martinkadauke/kabelsalat/bilder/etagen_iso.png

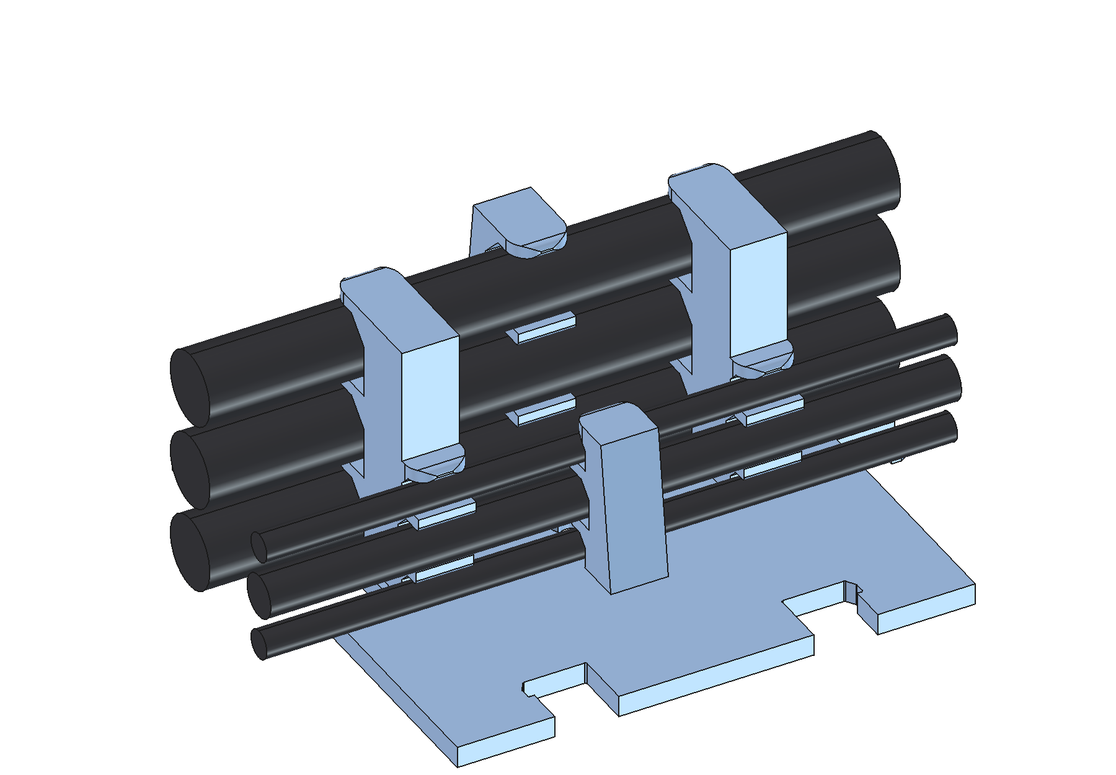
bilder/etagen_iso.png
