martinkadauke/kabelsalat/bilder/etagen_leer_iso.png

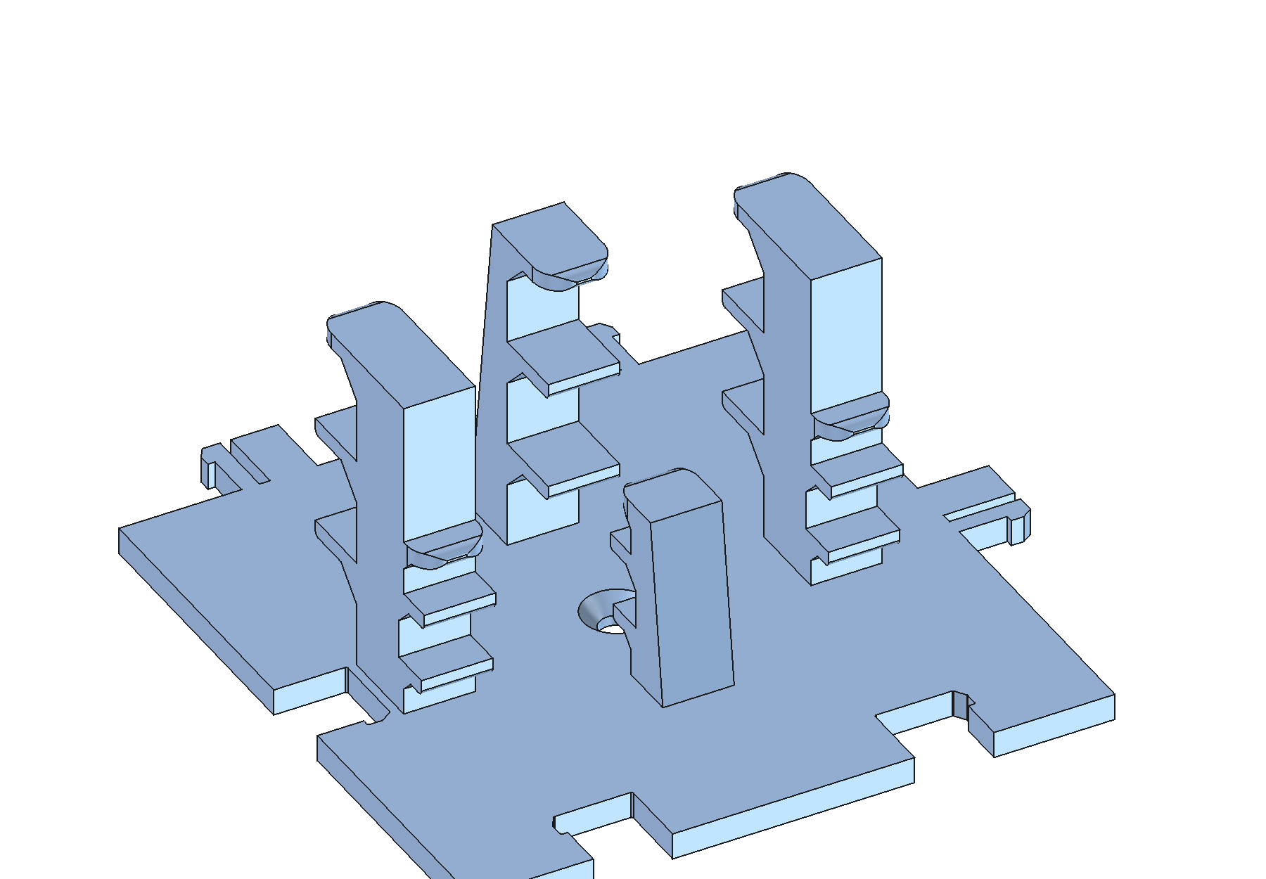
bilder/etagen_leer_iso.png
