martinkadauke/kabelsalat/bilder/etagen_mitte_schraeg.png

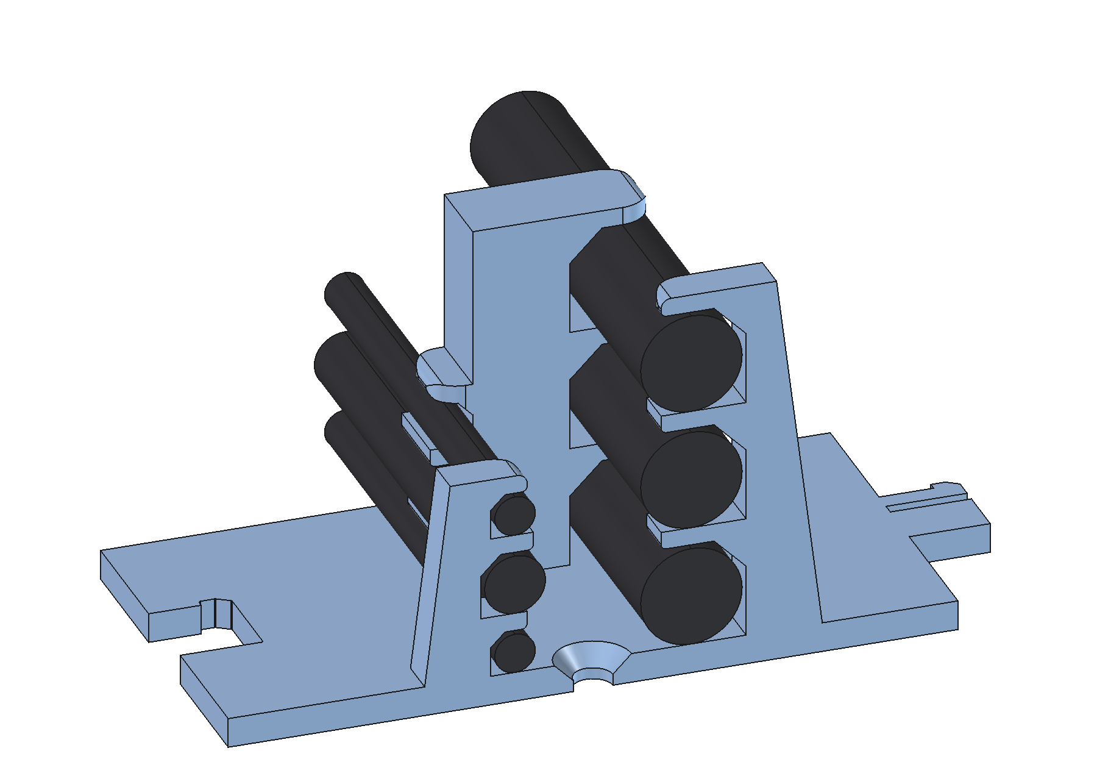
bilder/etagen_mitte_schraeg.png
