martinkadauke/kabelsalat/bilder/etagen_oben.png

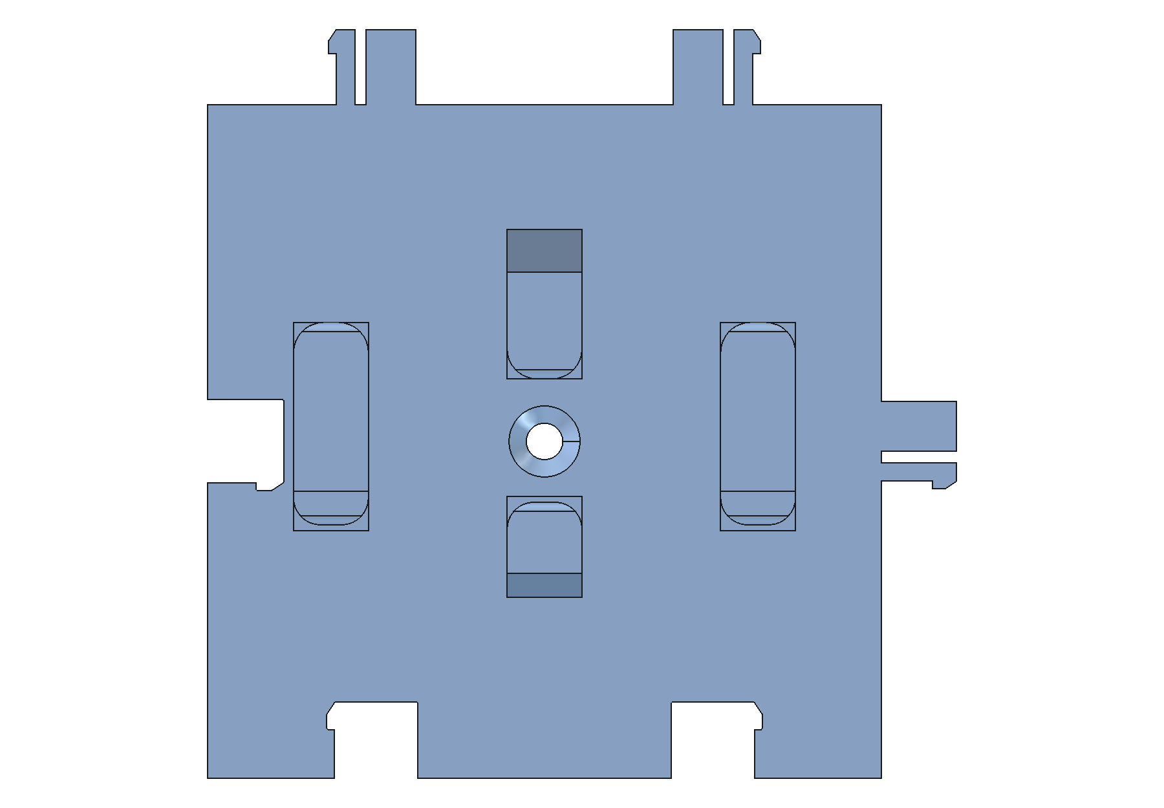
bilder/etagen_oben.png
