martinkadauke/kabelsalat/bilder/etagen_reihe.png

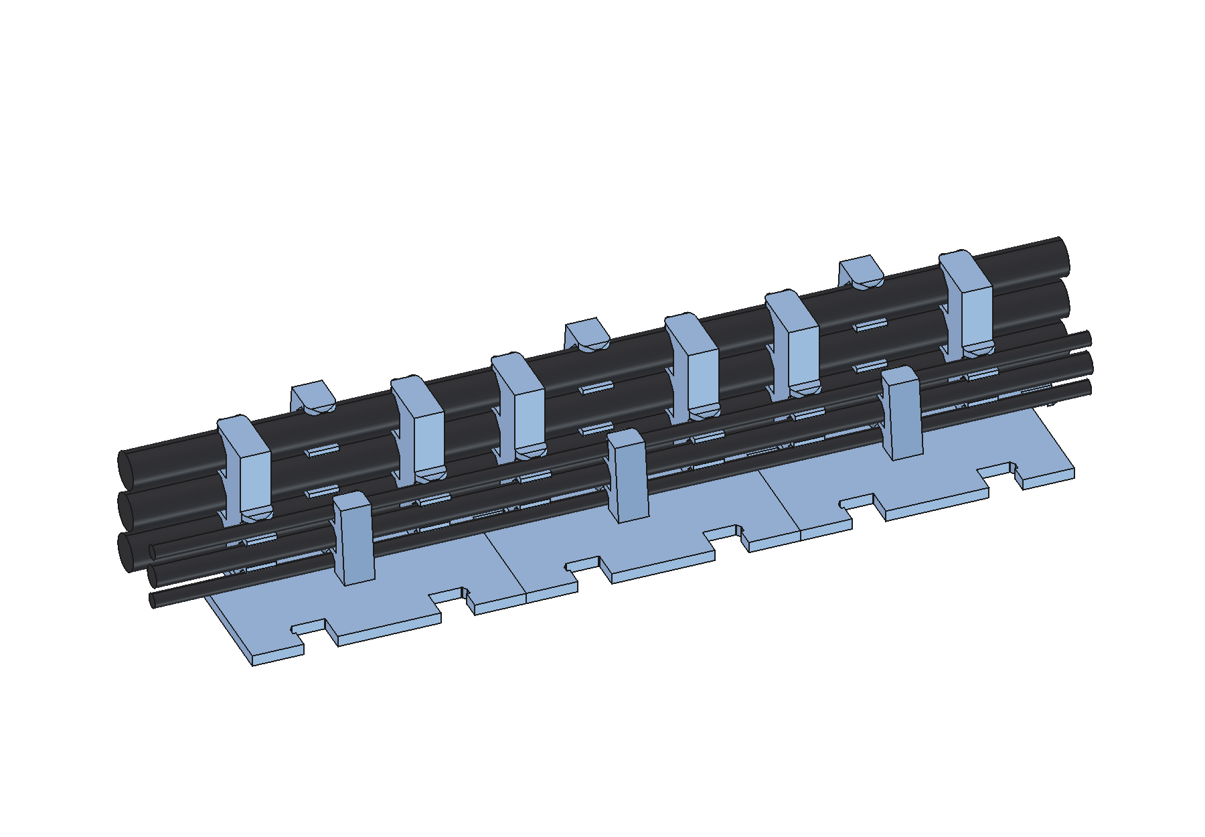
bilder/etagen_reihe.png
