martinkadauke/kabelsalat/bilder/etagen_schnitt.png

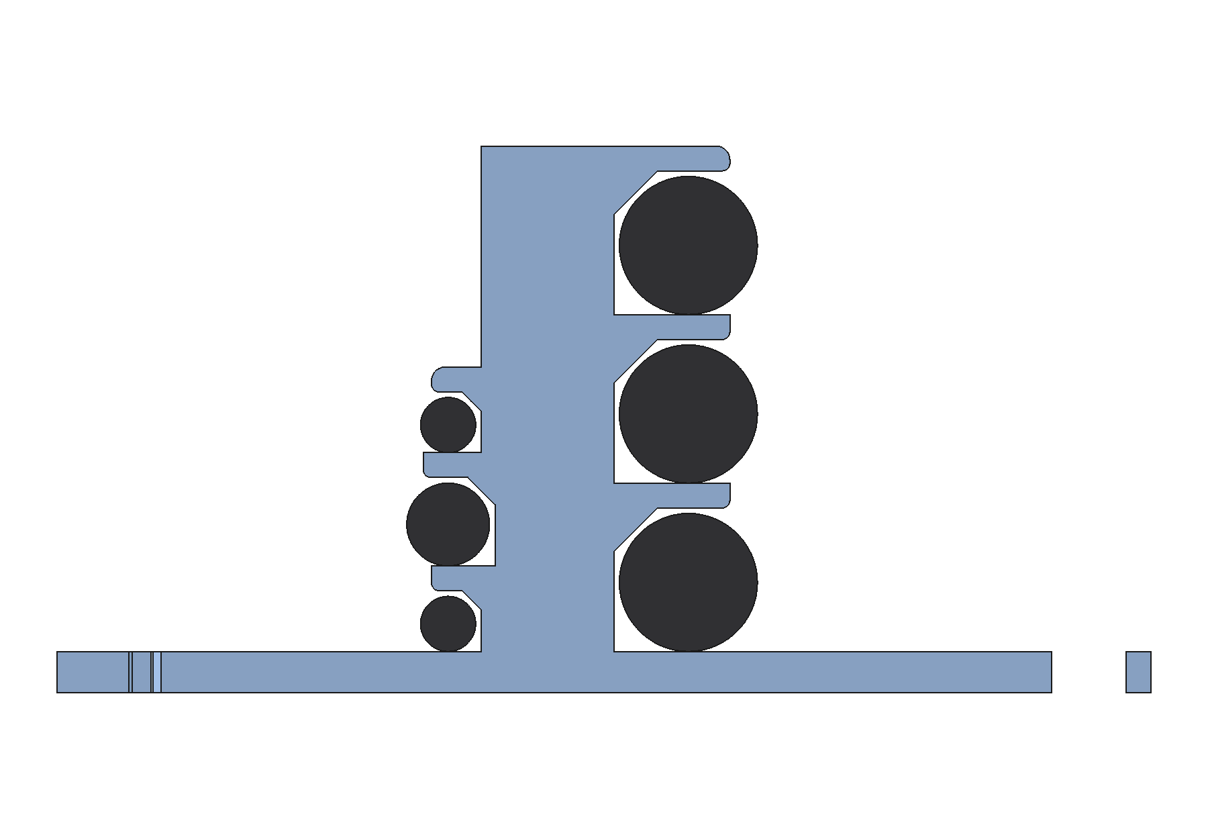
bilder/etagen_schnitt.png
