martinkadauke/kabelsalat/bilder/etagen_schnitt_schraeg.png

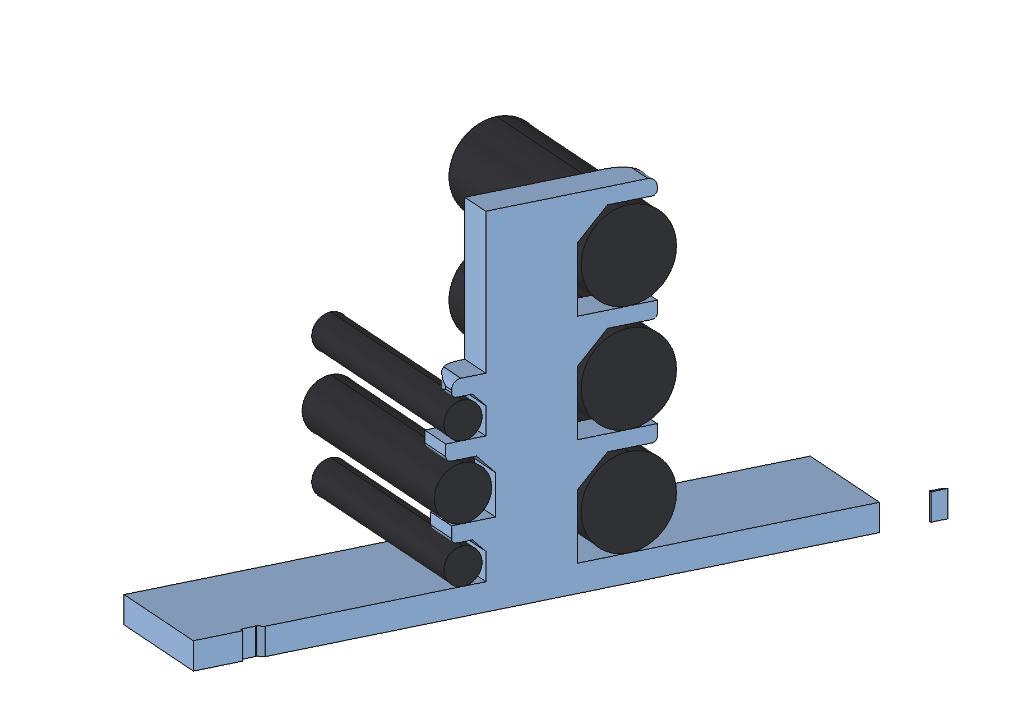
bilder/etagen_schnitt_schraeg.png
