martinkadauke/kabelsalat/bilder/etagen_vergleich.png

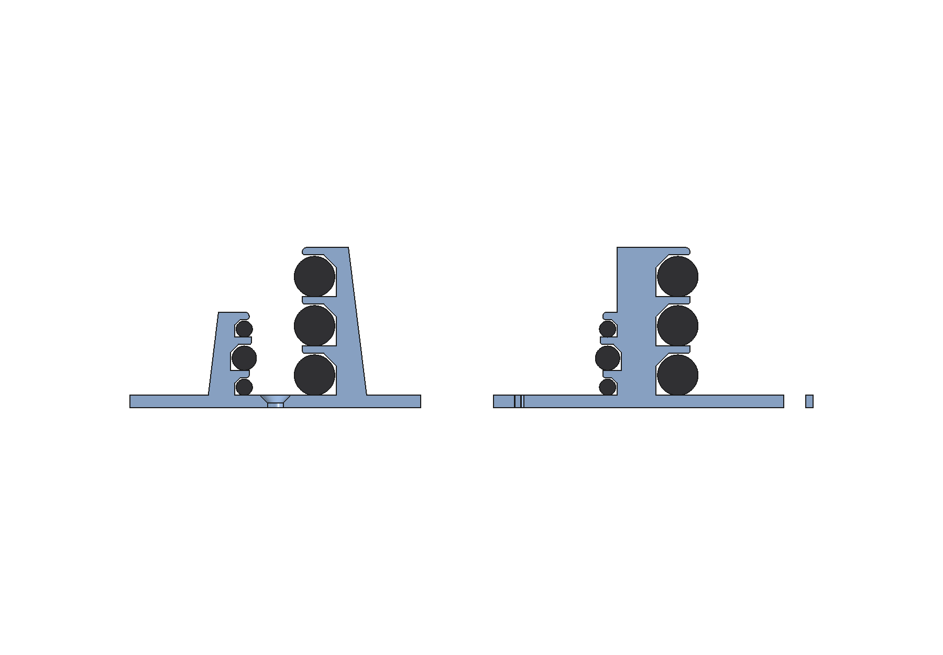
bilder/etagen_vergleich.png
