martinkadauke/kabelsalat/bilder/gemischt_iso.png

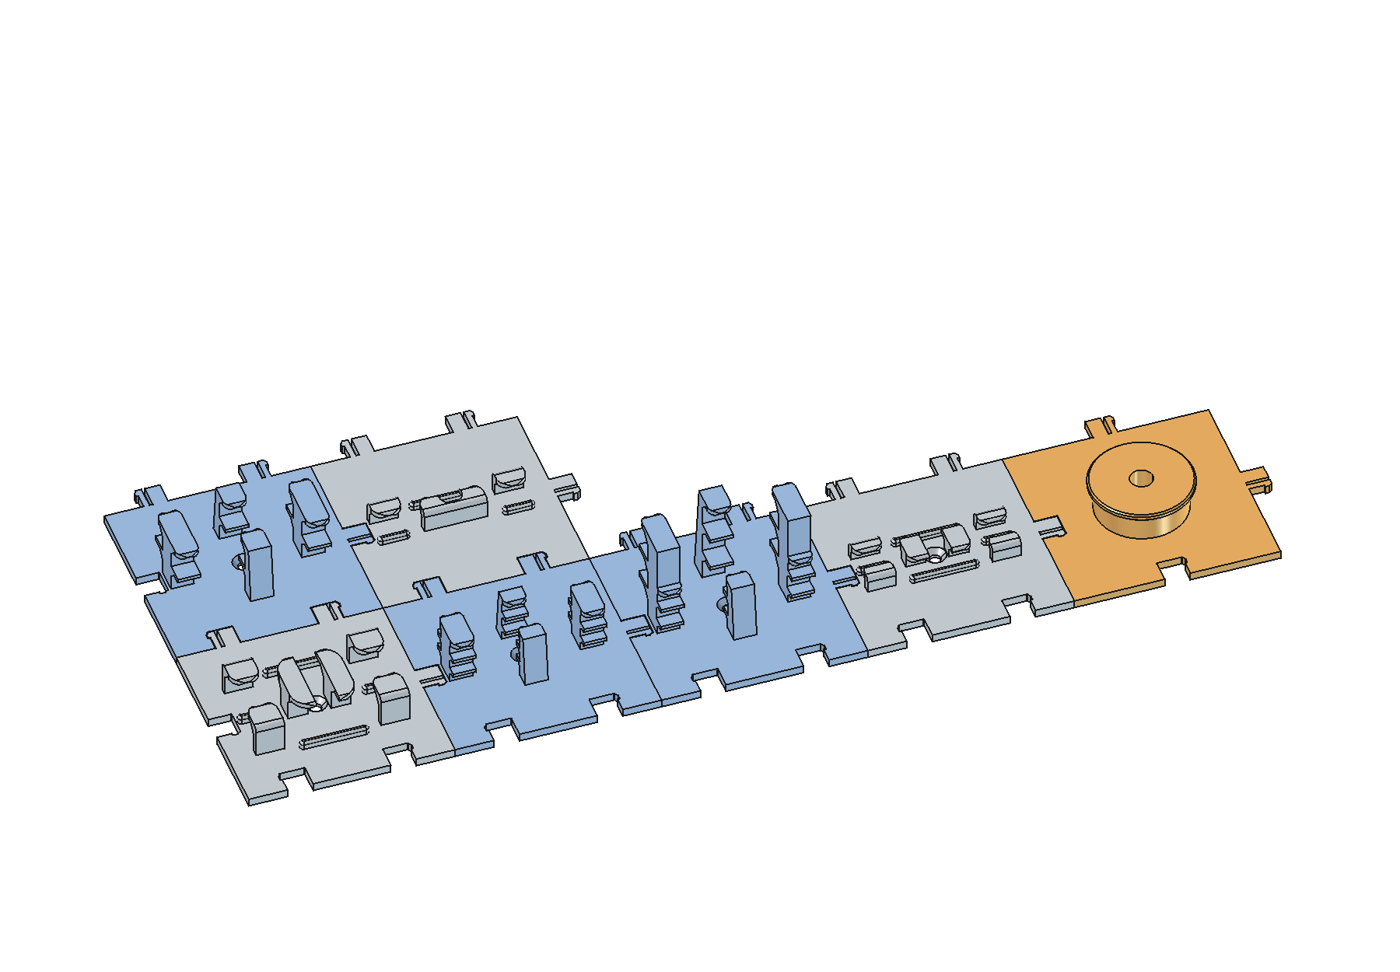
bilder/gemischt_iso.png
