martinkadauke/kabelsalat/bilder/gemischt_oben.png

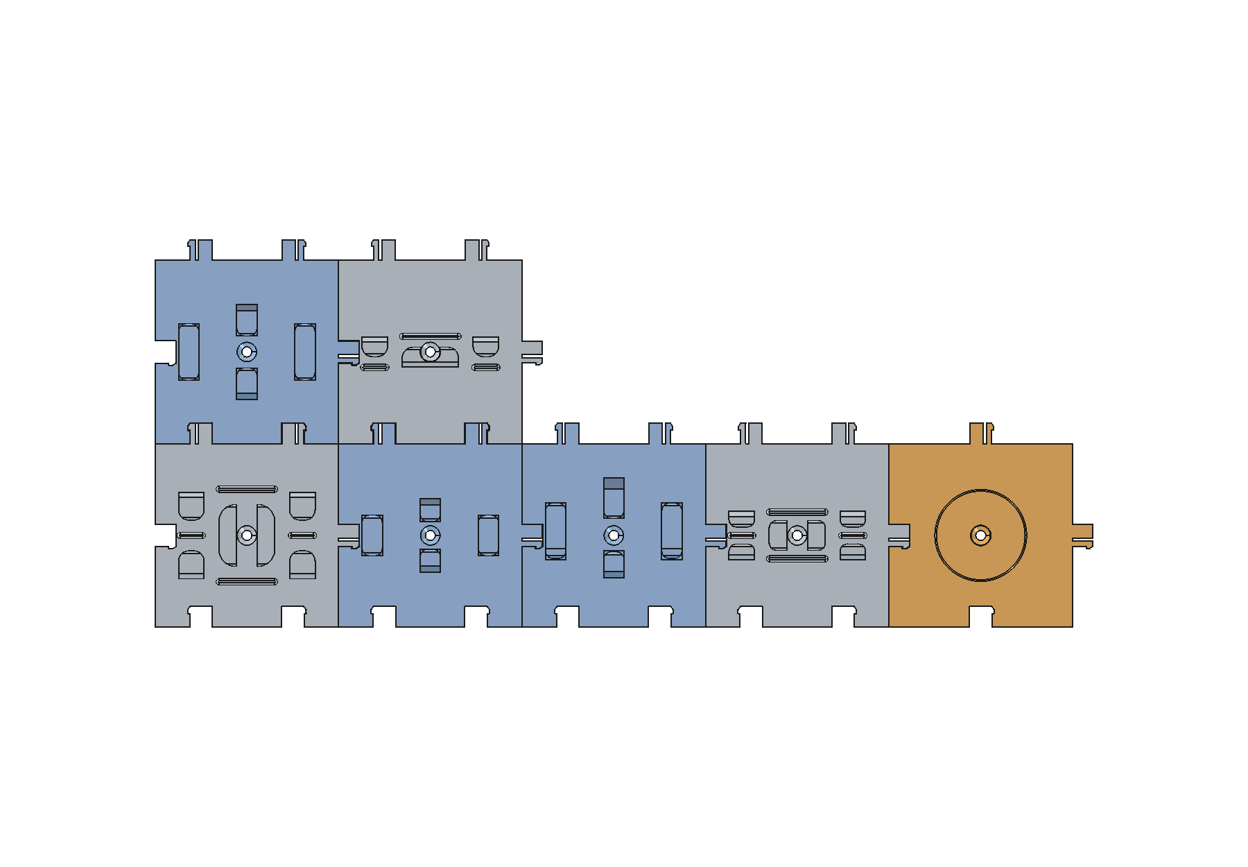
bilder/gemischt_oben.png
