martinkadauke/kabelsalat/bilder/grundformen.png

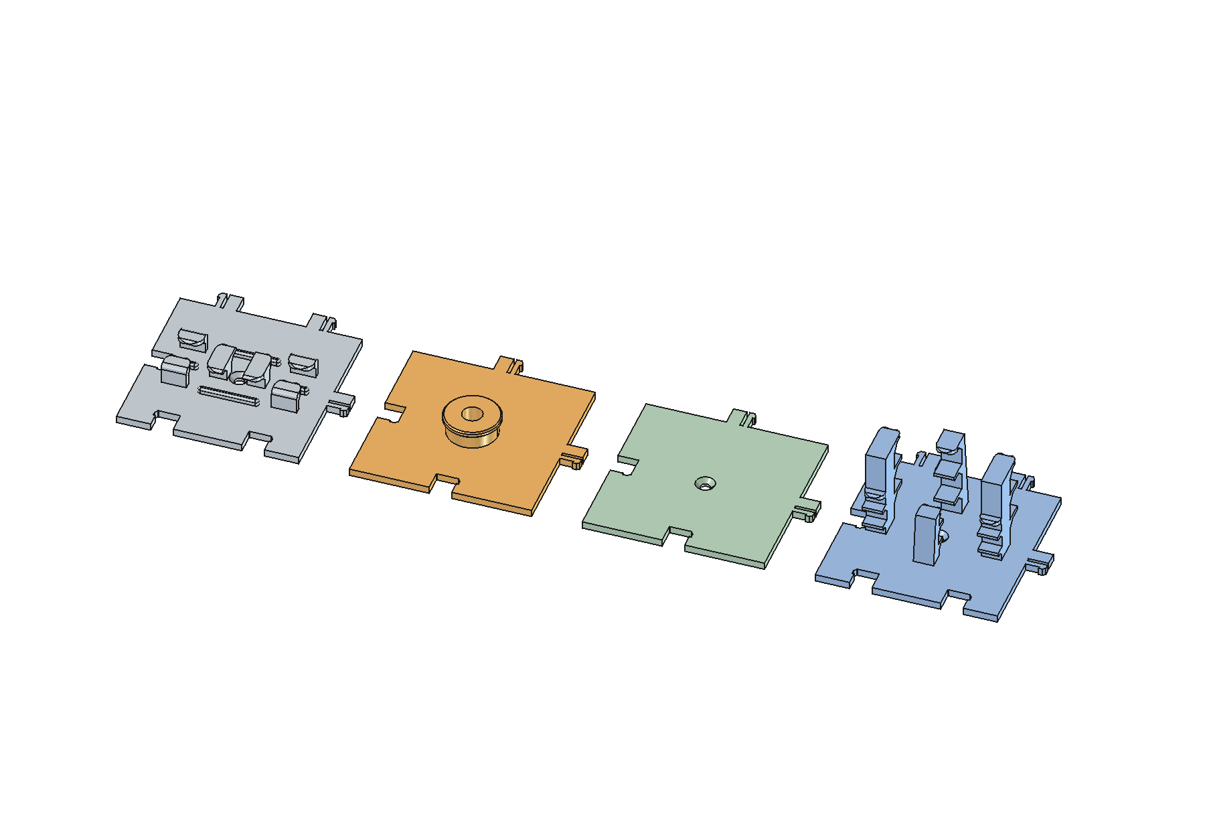
bilder/grundformen.png
