martinkadauke/kabelsalat/bilder/kachel_1spur_leer.png

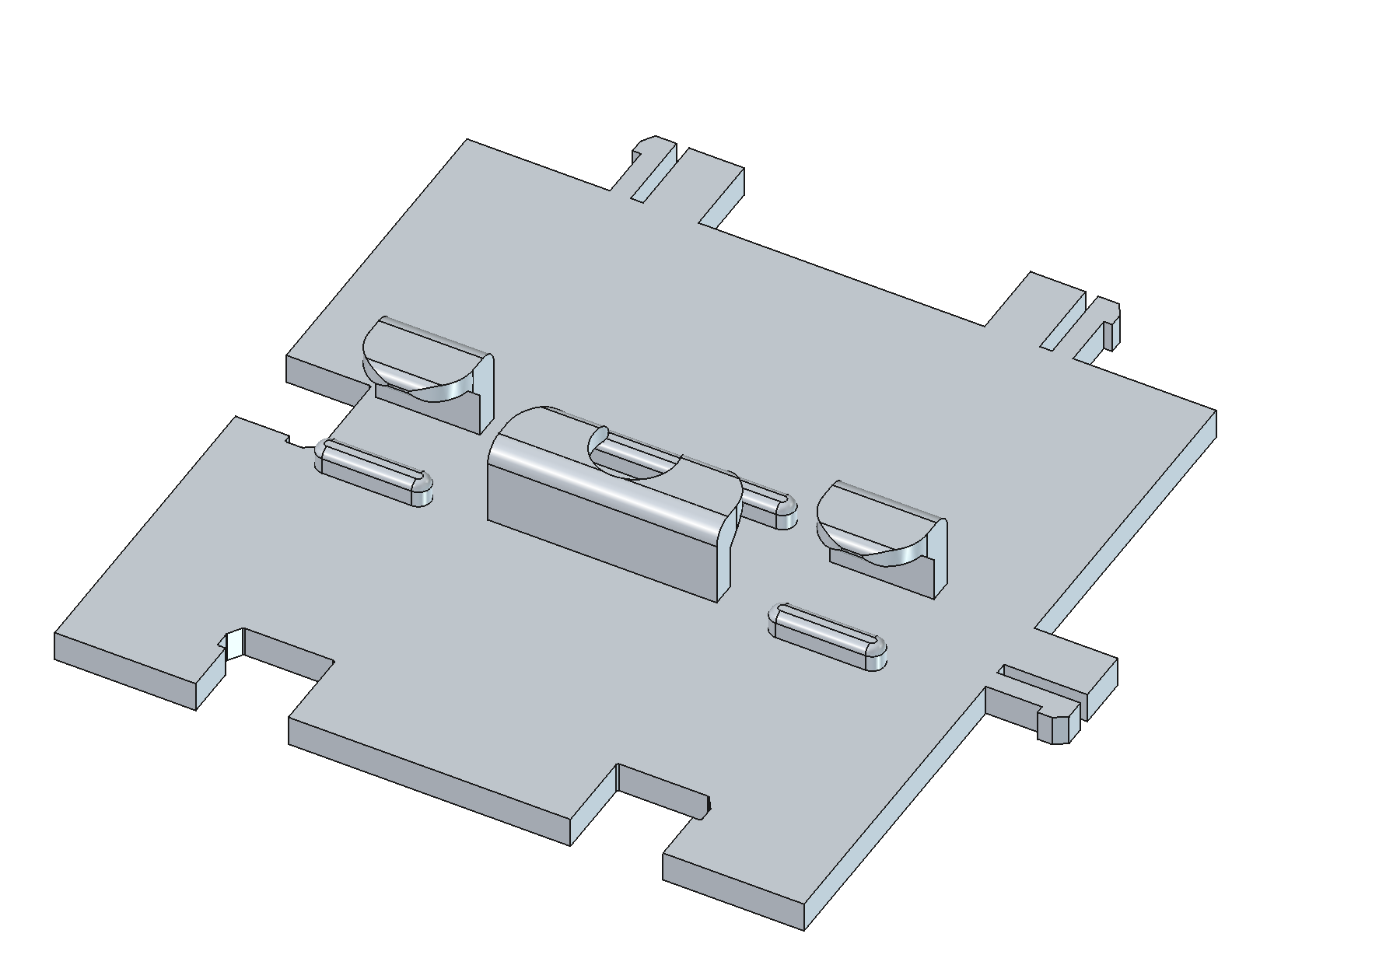
bilder/kachel_1spur_leer.png
