martinkadauke/kabelsalat/bilder/kachel_1spur_wie_foto.png

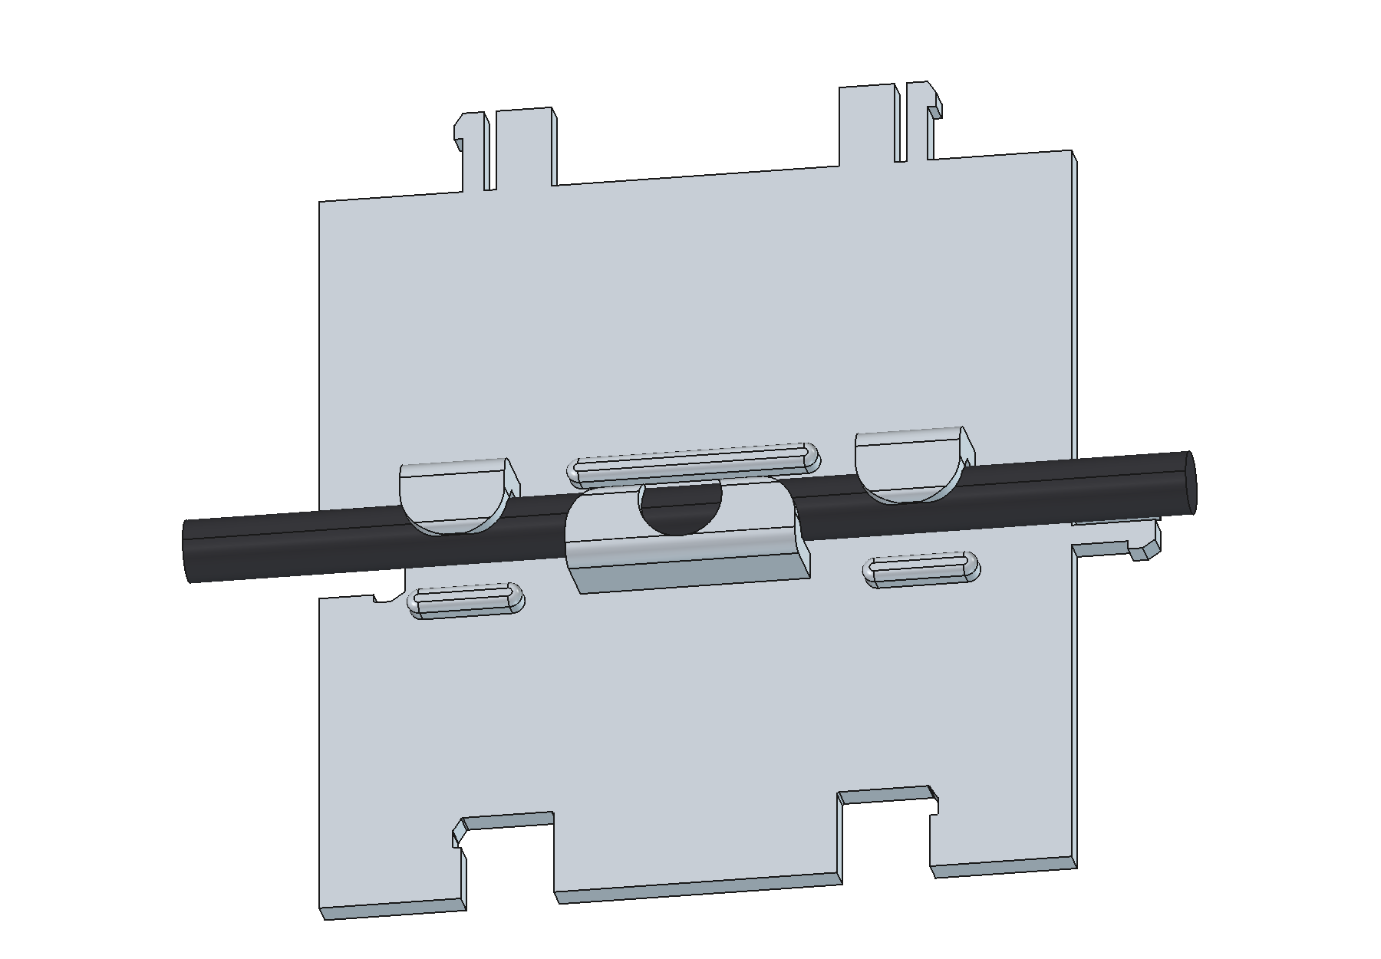
bilder/kachel_1spur_wie_foto.png
