martinkadauke/kabelsalat/bilder/kachel_2spur_wie_foto.png

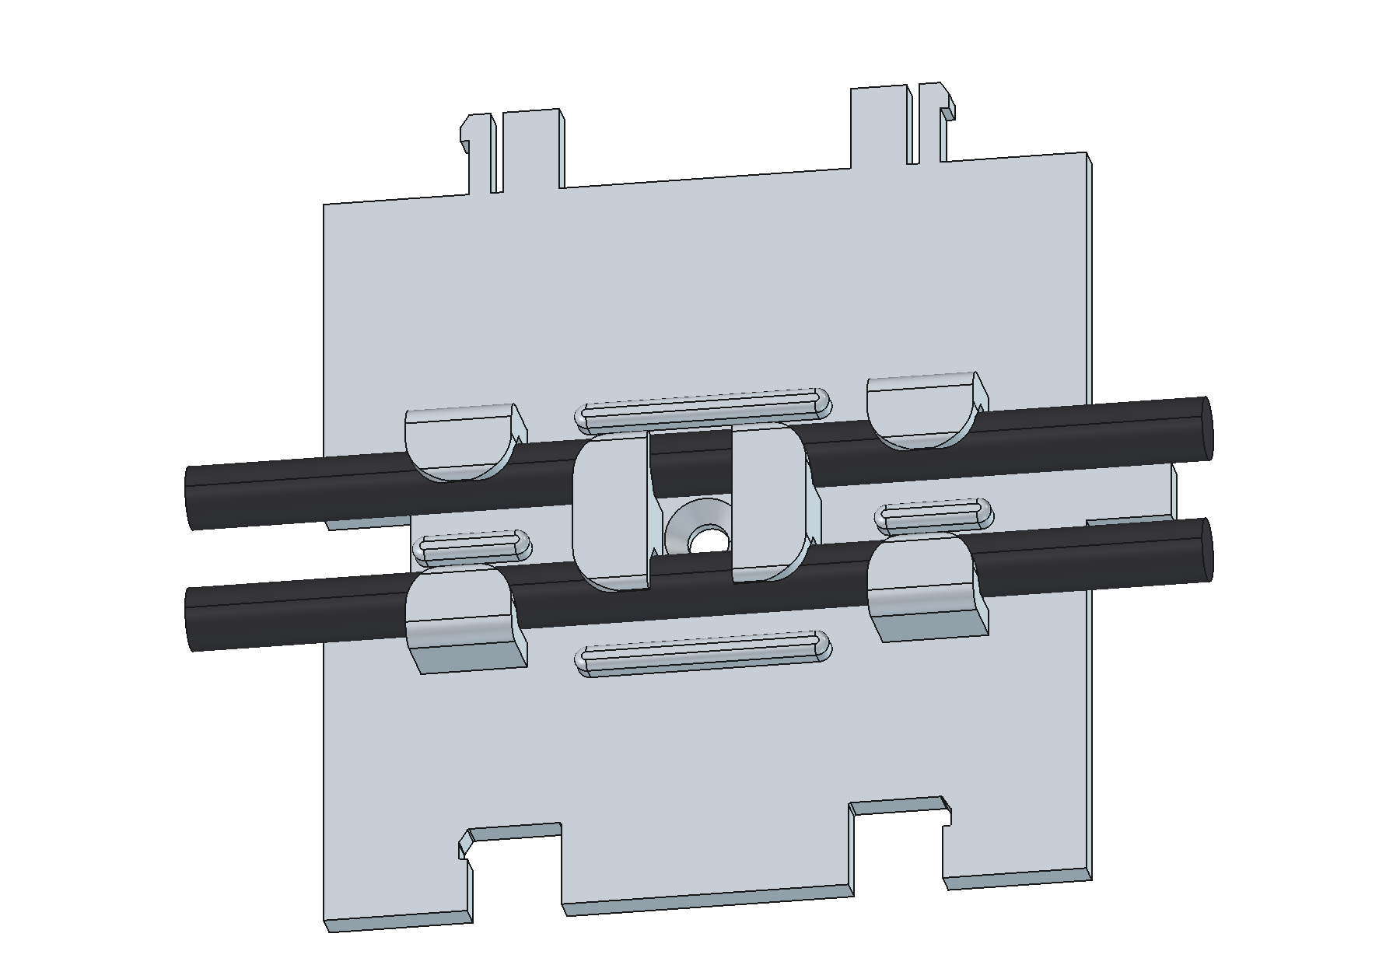
bilder/kachel_2spur_wie_foto.png
