martinkadauke/kabelsalat/bilder/kachel_iso.png

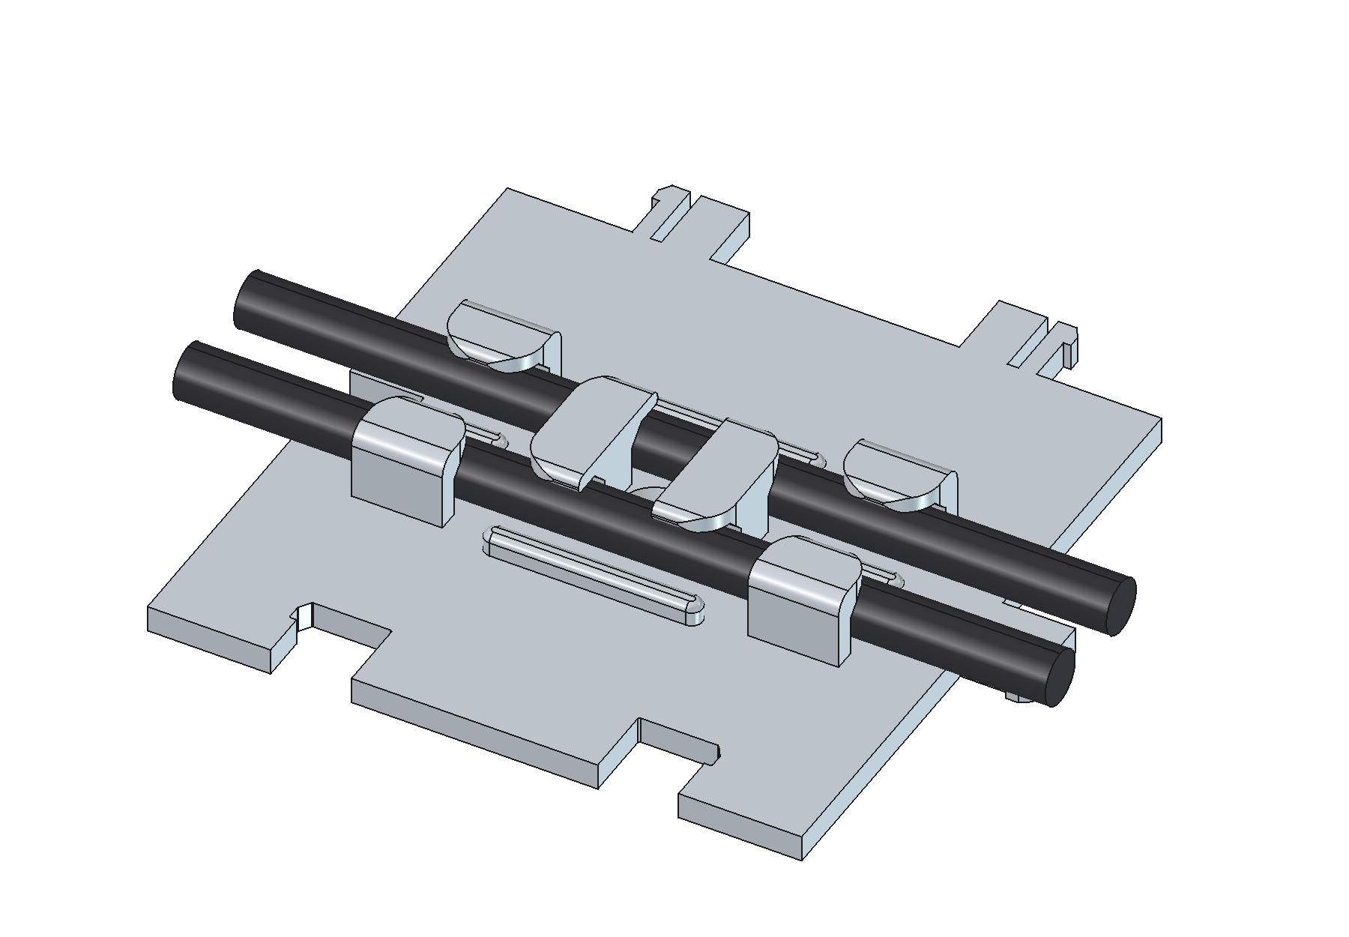
bilder/kachel_iso.png
