martinkadauke/kabelsalat/bilder/kachel_leer_iso.png

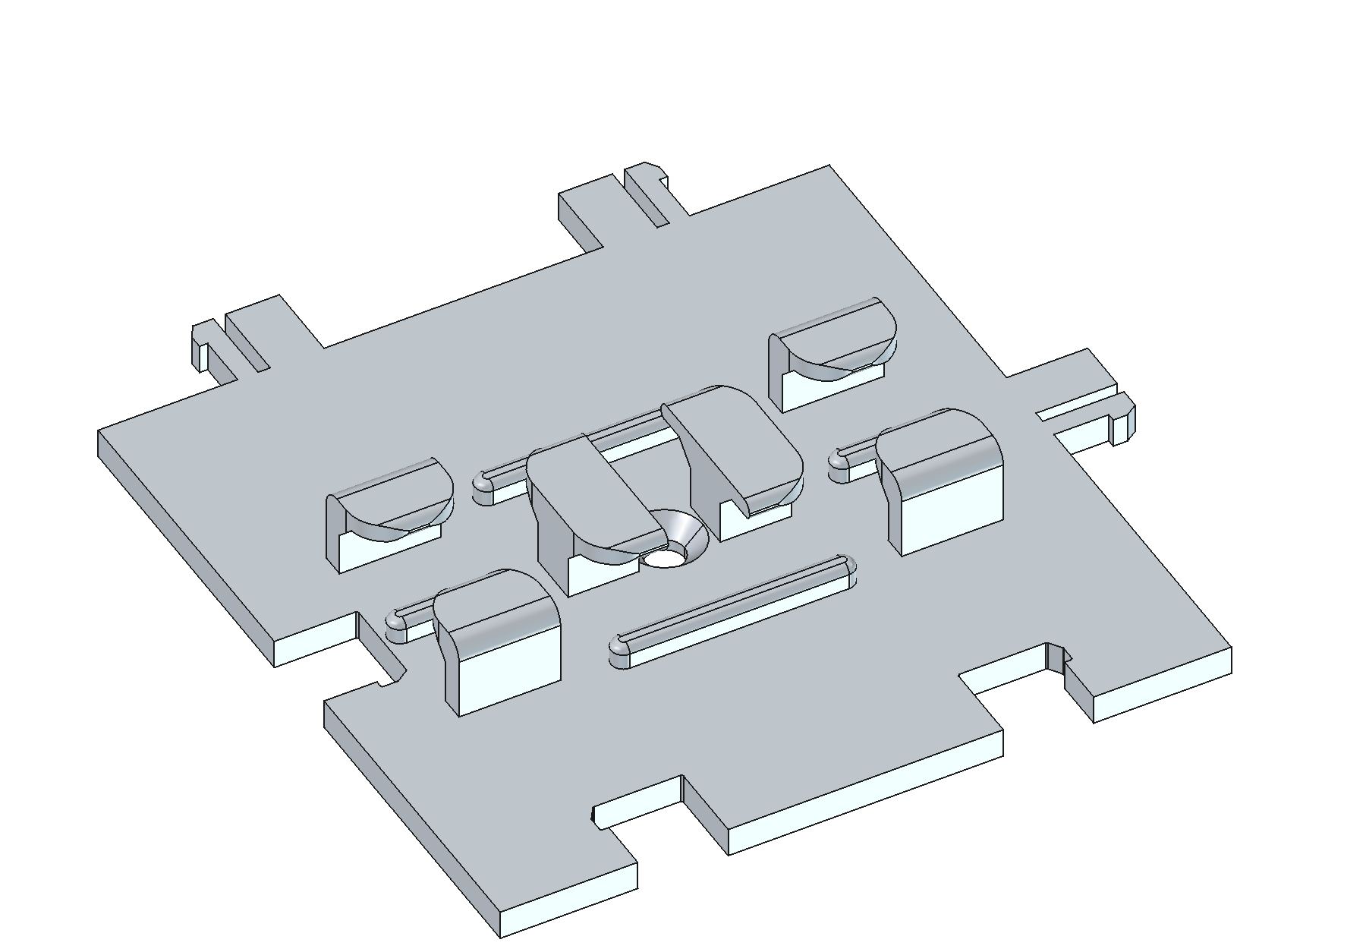
bilder/kachel_leer_iso.png
