martinkadauke/kabelsalat/bilder/kachel_oben.png

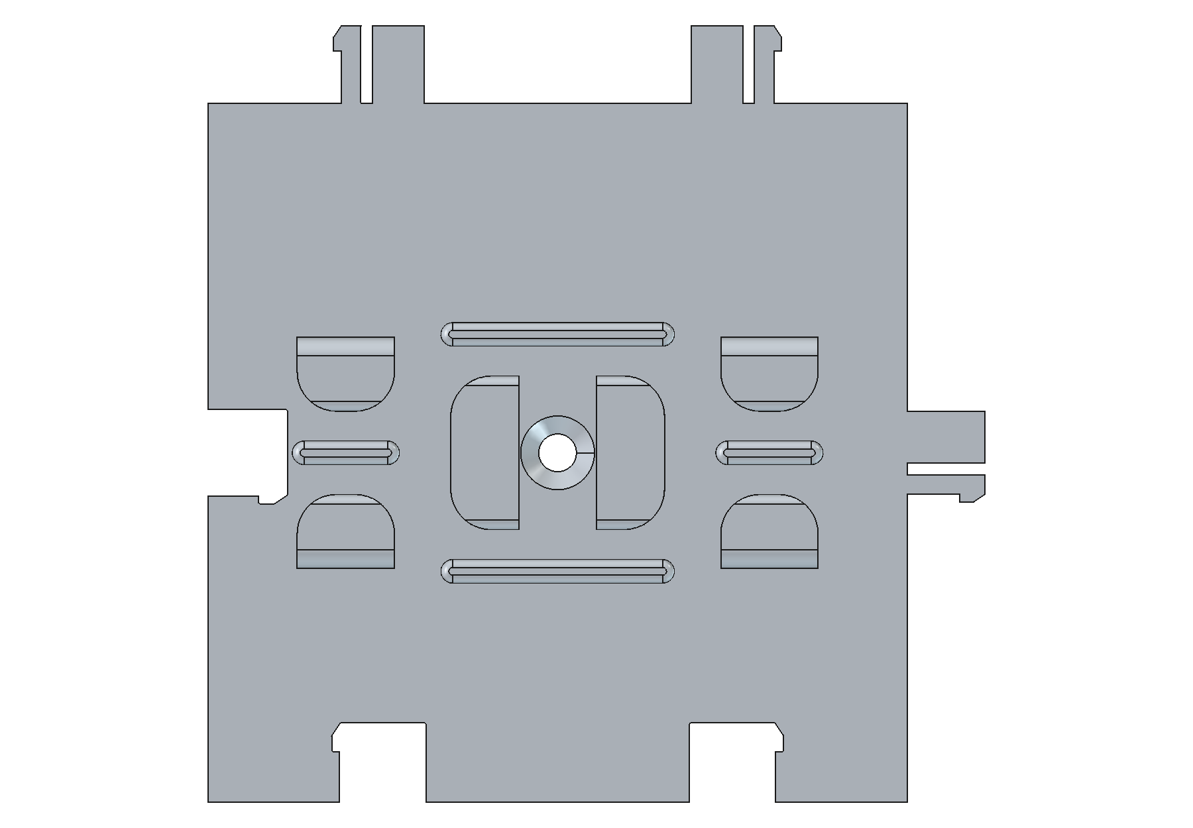
bilder/kachel_oben.png
