martinkadauke/kabelsalat/bilder/kreisverkehr_iso.png

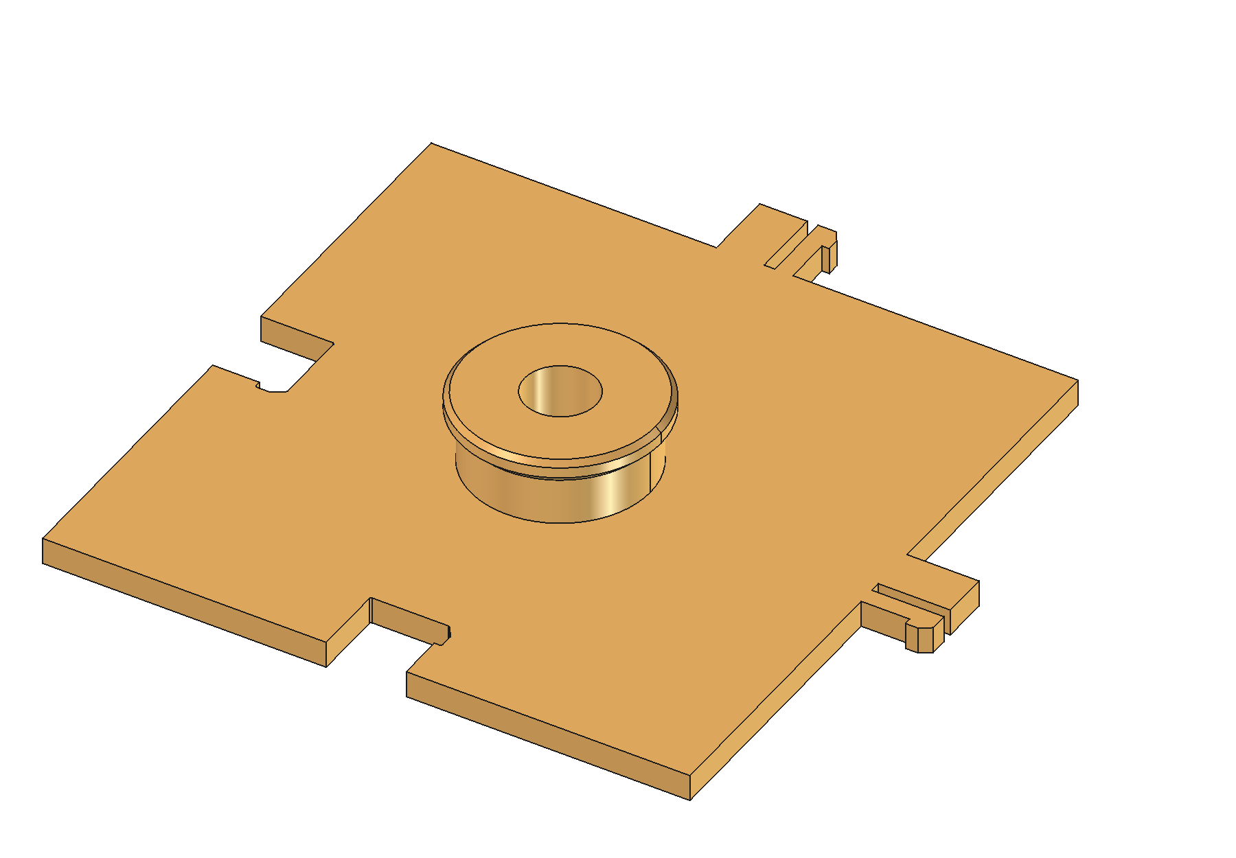
bilder/kreisverkehr_iso.png
