martinkadauke/kabelsalat/bilder/kreuzung_oben.png

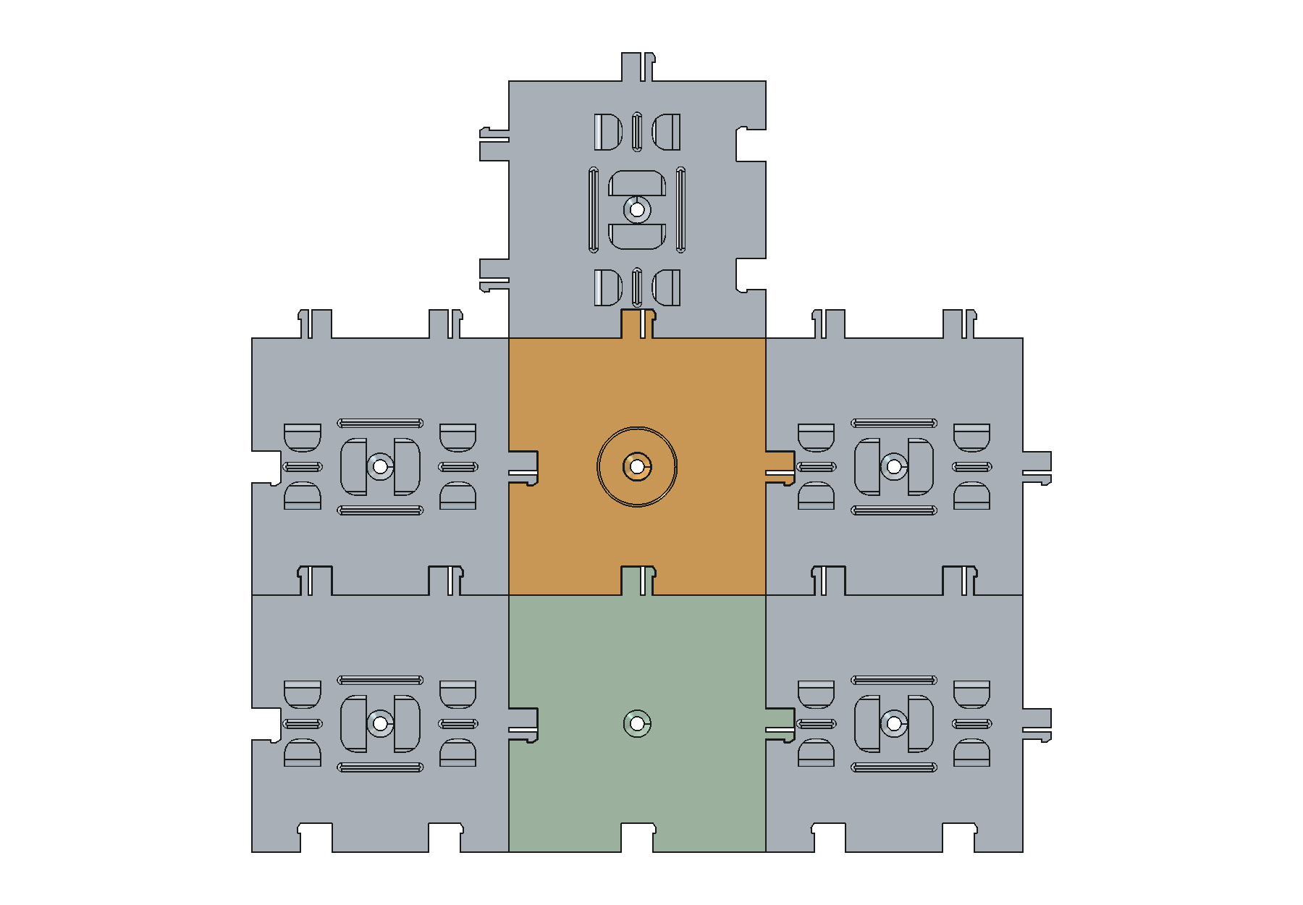
bilder/kreuzung_oben.png
