martinkadauke/kabelsalat/bilder/schnitt_aussenhaken.png

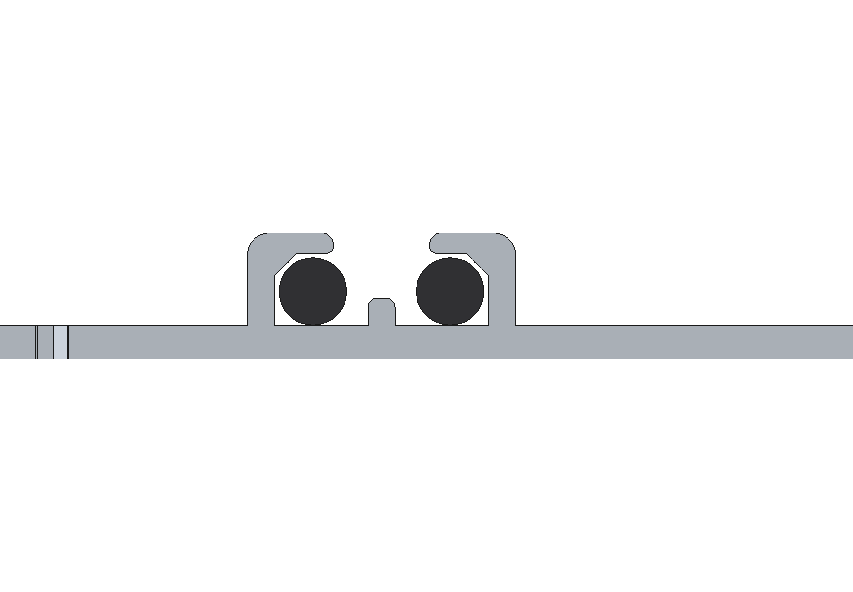
bilder/schnitt_aussenhaken.png
