martinkadauke/kabelsalat/bilder/schnitt_aussenhaken_schraeg.png

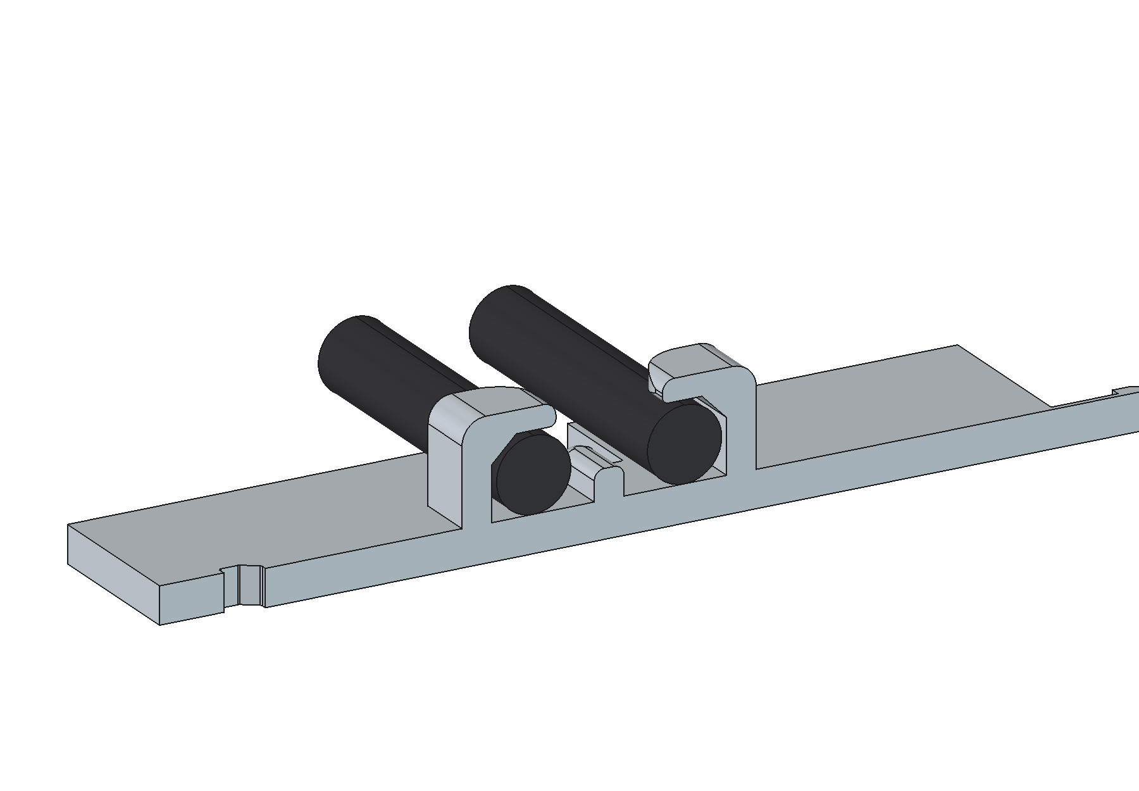
bilder/schnitt_aussenhaken_schraeg.png
