martinkadauke/kabelsalat/bilder/unterseite.png

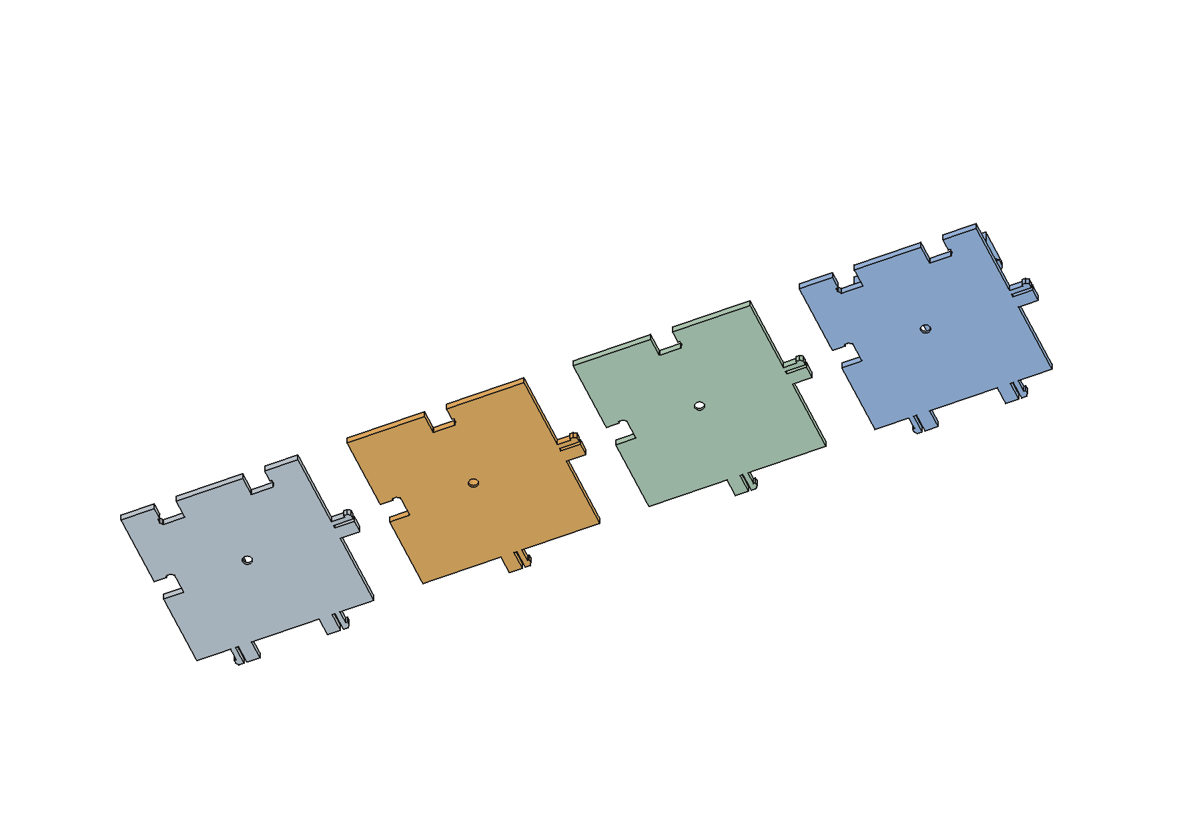
bilder/unterseite.png
