martinkadauke/kabelsalat/bilder/verbindung_oben.png

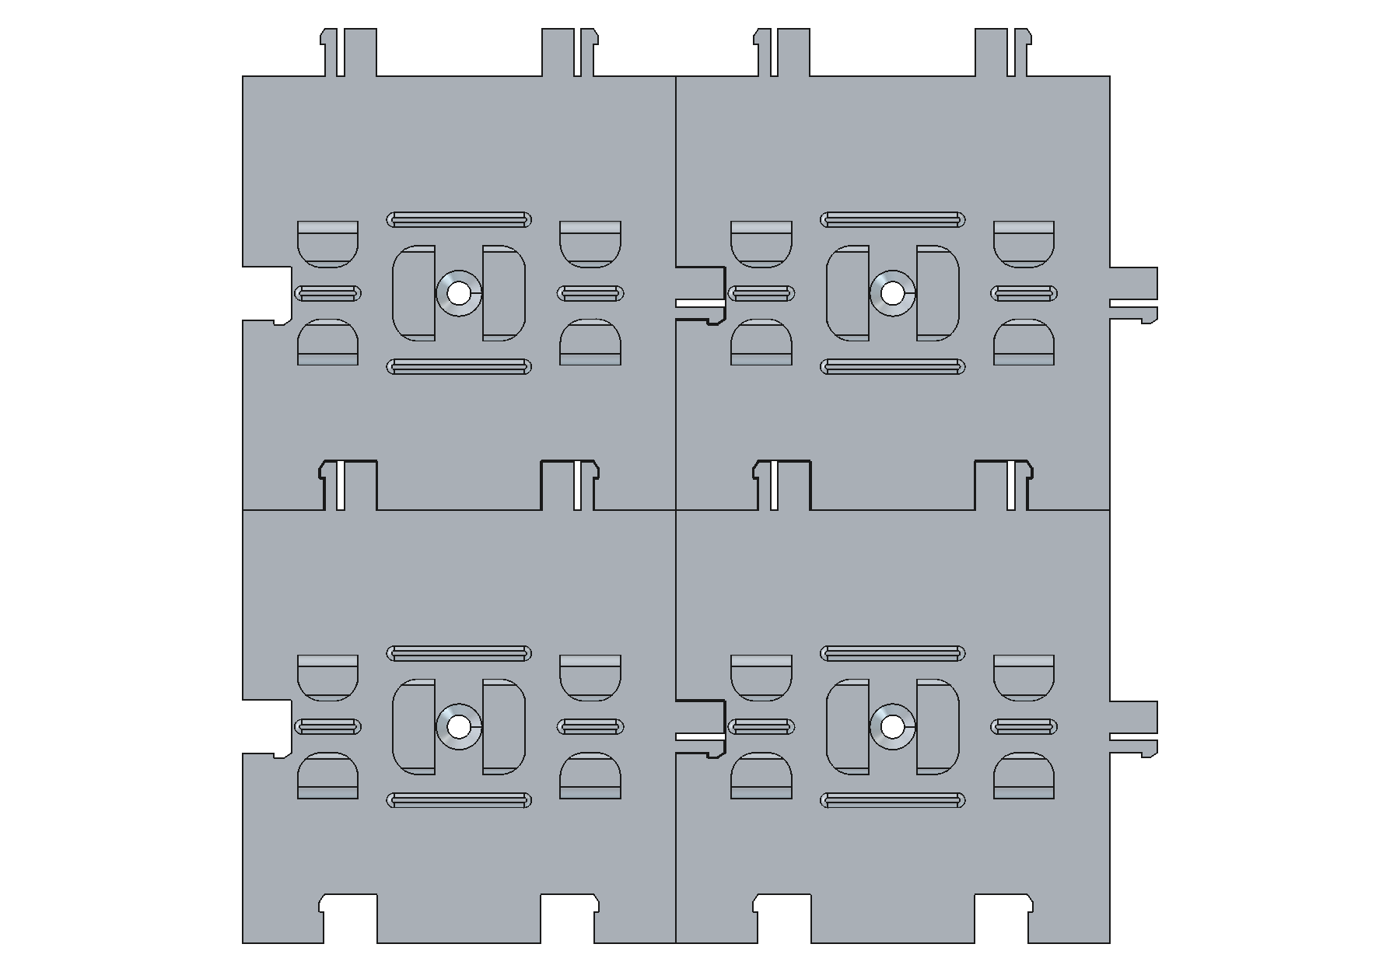
bilder/verbindung_oben.png
