martinkadauke/kabelsalat/druck/v4/06_Dreidecker_6mm_print.stl

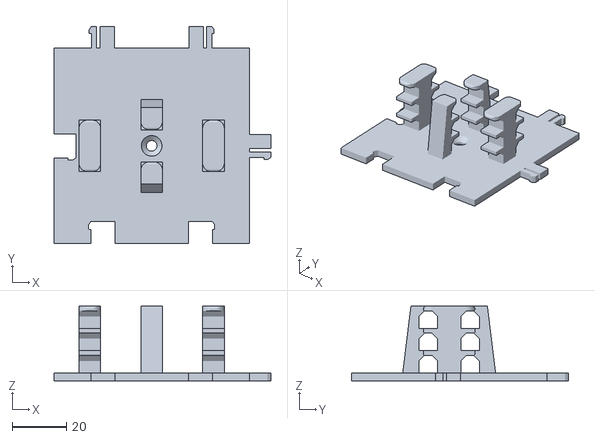
[picture p26: CAD file, 2026-10-27]
druck/v4/06_Dreidecker_6mm_print.stl
80.0 x 80.0 x 27.6
