martinkadauke/kabelsalat/generiert/Etagen_A4-6-4_B10-10-10.stl

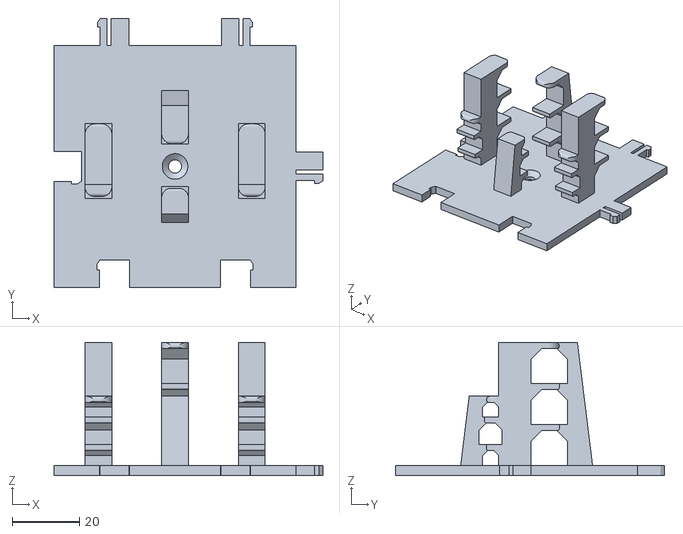
[picture p27: CAD file, 2026-10-27]
generiert/Etagen_A4-6-4_B10-10-10.stl
80.0 x 80.0 x 39.6
