martinkadauke/kabelsalat/kabelfuehrung.FCStd

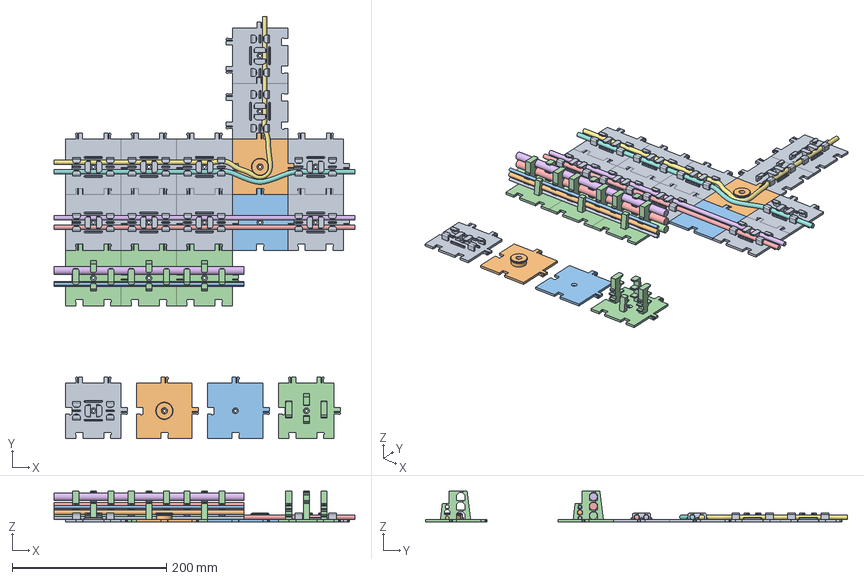
[picture p28: CAD file, 2026-10-27]
kabelfuehrung.FCStd
390.0 x 547.0 x 39.6 mm
Kabelkachel x 11
Kreisverkehr x 2
Leerkachel x 2
Etagenkachel x 4
Kabel_B1
Kabel_B2
Kabel_A_um_Poller
Kabel_A_gerade
Kabel_CA1
Kabel_CA2
Kabel_CA3
Kabel_CB1
Kabel_CB2
Kabel_CB3
