martinkadauke/kabelsalat/druck/v4/05_Doppeldecker_6mm_print.stl

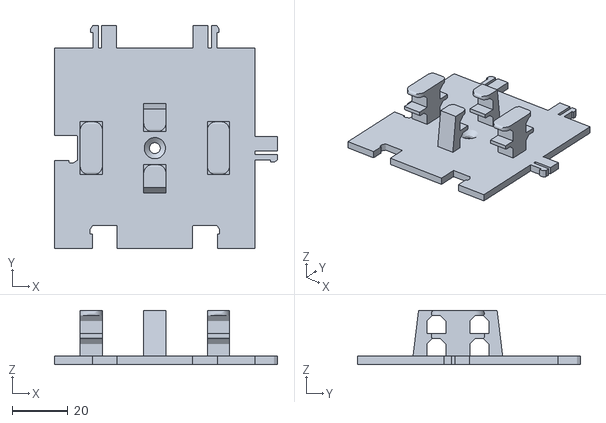
[picture p29: CAD file, 2026-10-27]
druck/v4/05_Doppeldecker_6mm_print.stl
80.0 x 80.0 x 19.4
