martinkadauke/kabelsalat/druck/v4/12_Dreidecker_10mm_print.stl

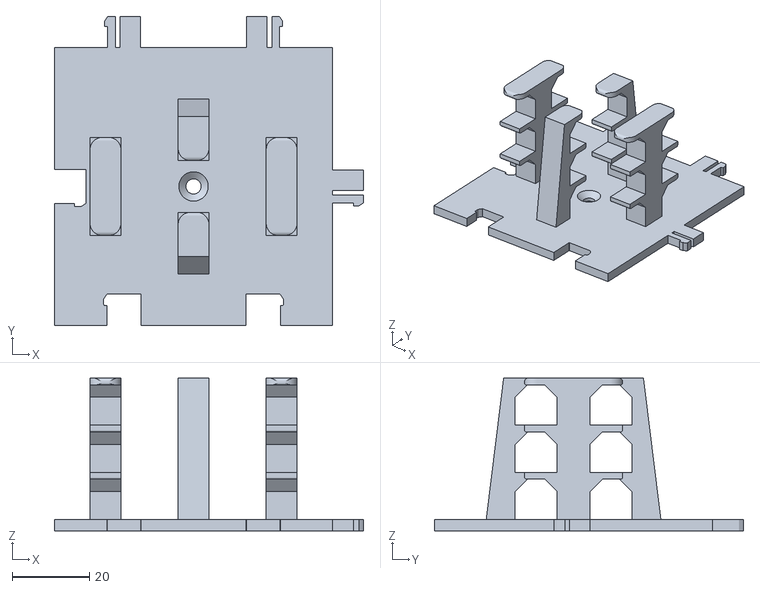
[picture p30: CAD file, 2026-10-27]
druck/v4/12_Dreidecker_10mm_print.stl
80.0 x 80.0 x 39.6
