martinkadauke/kabelsalat/druck/v4/02_Doppeldecker_4mm_print.stl

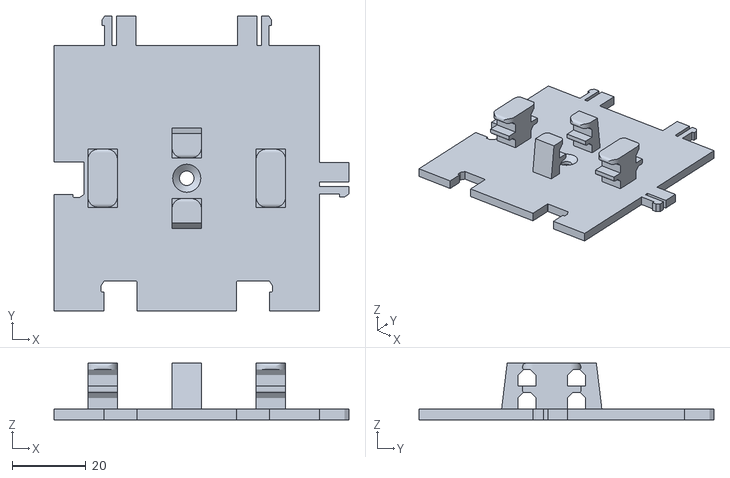
[picture p31: CAD file, 2026-10-27]
druck/v4/02_Doppeldecker_4mm_print.stl
80.0 x 80.0 x 15.4
