martinkadauke/kabelsalat/druck/v4/08_Doppeldecker_8mm_print.stl

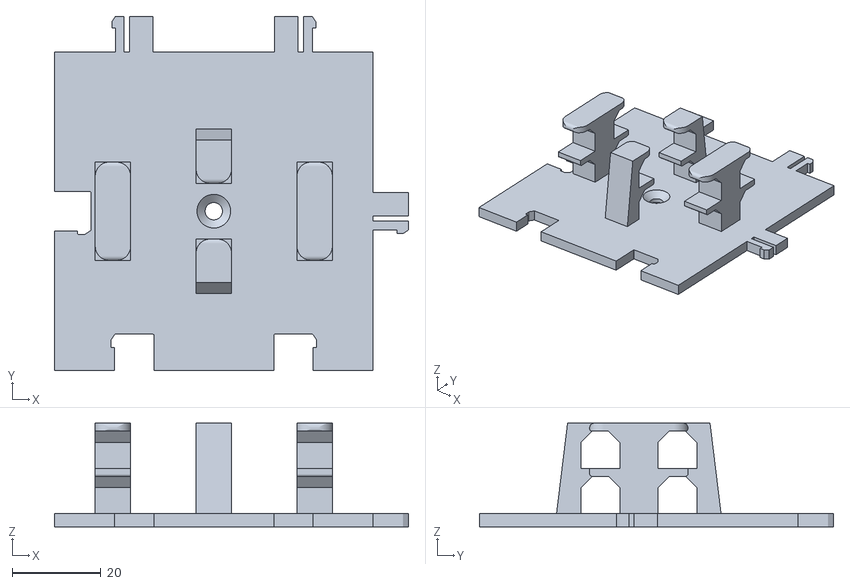
[picture p32: CAD file, 2026-10-27]
druck/v4/08_Doppeldecker_8mm_print.stl
80.0 x 80.0 x 23.4
