martinkadauke/kabelsalat/druck/v4/11_Doppeldecker_10mm_print.stl

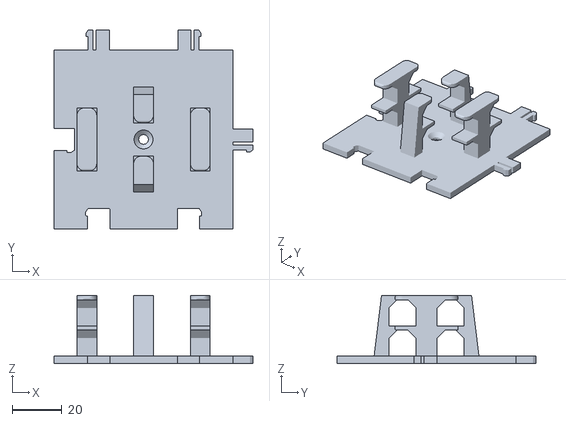
[picture p33: CAD file, 2026-10-27]
druck/v4/11_Doppeldecker_10mm_print.stl
80.0 x 80.0 x 27.4
