martinkadauke/kabelsalat/druck/v4/09_Dreidecker_8mm_print.stl

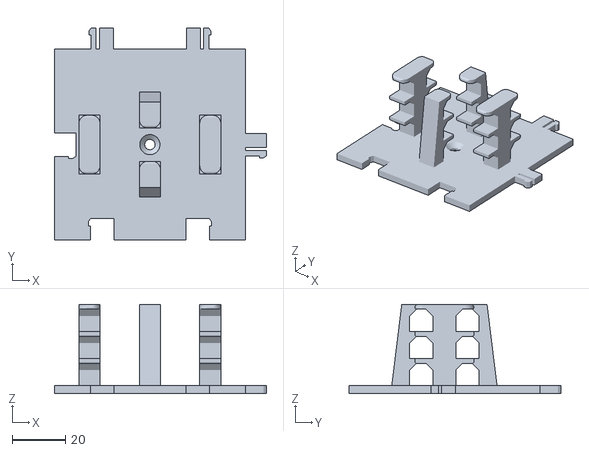
[picture p34: CAD file, 2026-10-27]
druck/v4/09_Dreidecker_8mm_print.stl
80.0 x 80.0 x 33.6
