martinkadauke/kabelsalat/druck/v4/03_Dreidecker_4mm_print.stl

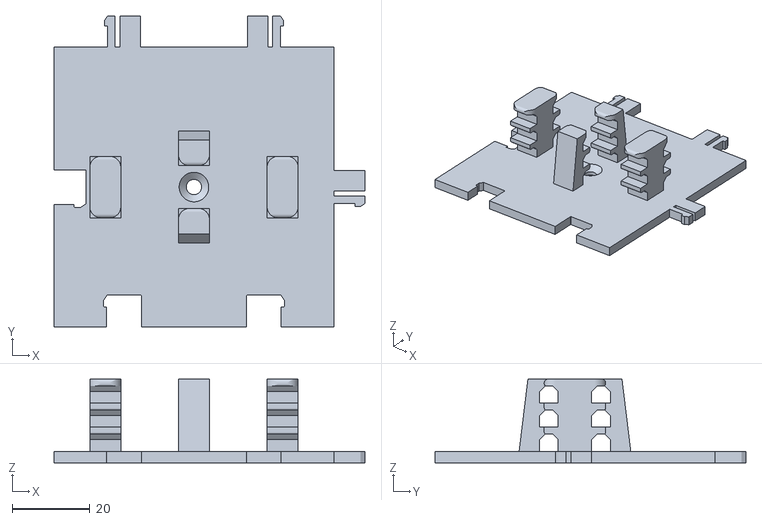
[picture p35: CAD file, 2026-10-27]
druck/v4/03_Dreidecker_4mm_print.stl
80.0 x 80.0 x 21.6
