martinkadauke/kabelsalat/druck/v4/13_Kreisverkehr_bis10mm_print.stl

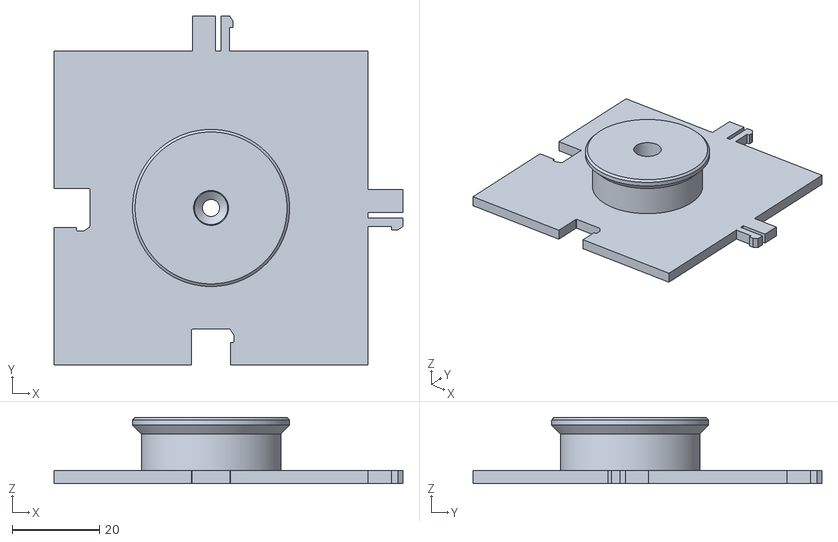
[picture p36: CAD file, 2026-10-27]
druck/v4/13_Kreisverkehr_bis10mm_print.stl
80.0 x 80.0 x 15.2
