martinkadauke/kabelsalat/druck/v4/10_Kabelkachel_10mm_2spur_print.stl

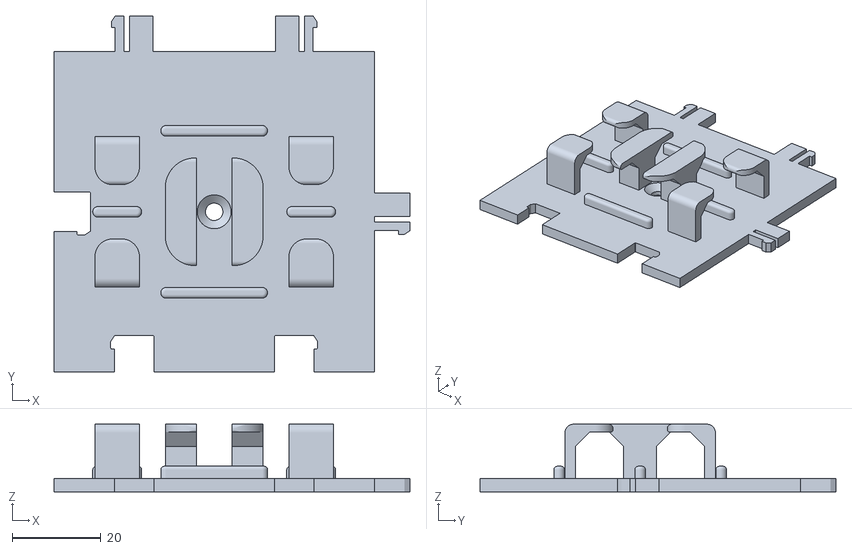
[picture p37: CAD file, 2026-10-27]
druck/v4/10_Kabelkachel_10mm_2spur_print.stl
80.0 x 80.0 x 15.2
