martinkadauke/kabelsalat/druck/v4/14_Leerkachel_print.stl

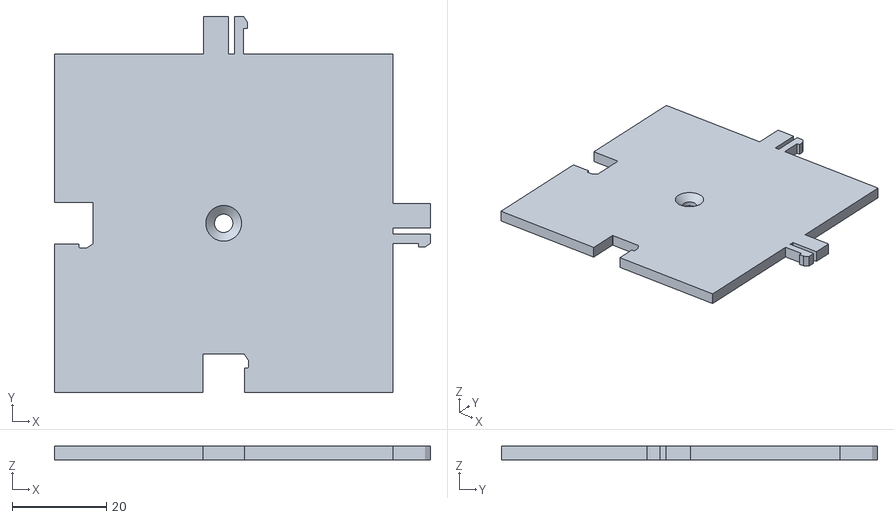
[picture p38: CAD file, 2026-10-27]
druck/v4/14_Leerkachel_print.stl
80.0 x 80.0 x 3.00
