martinkadauke/kabelsalat/druck/v4/04_Kabelkachel_6mm_2spur_print.stl

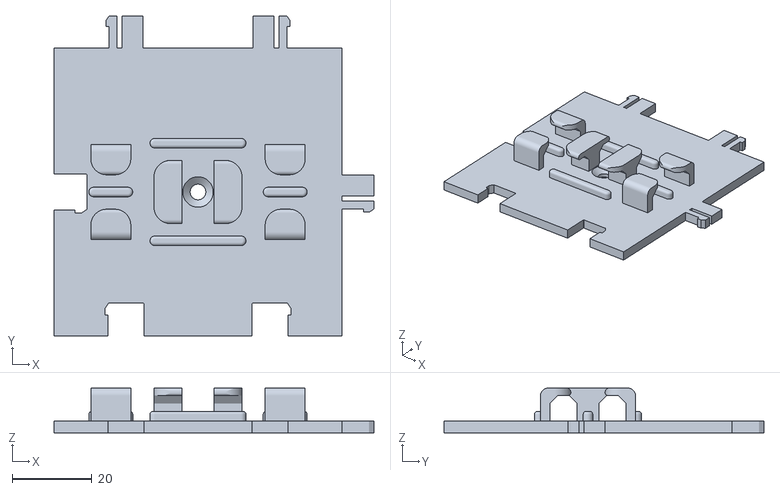
[picture p39: CAD file, 2026-10-27]
druck/v4/04_Kabelkachel_6mm_2spur_print.stl
80.0 x 80.0 x 11.2
