martinkadauke/kabelsalat/druck/v4/07_Kabelkachel_8mm_2spur_print.stl

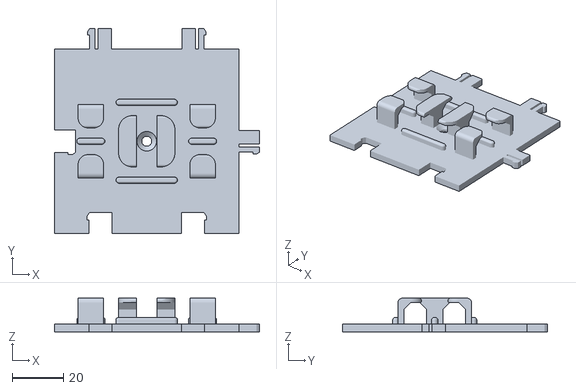
[picture p40: CAD file, 2026-10-27]
druck/v4/07_Kabelkachel_8mm_2spur_print.stl
80.0 x 80.0 x 13.2
