martinkadauke/kabelsalat/druck/v4/01_Kabelkachel_4mm_2spur_print.stl

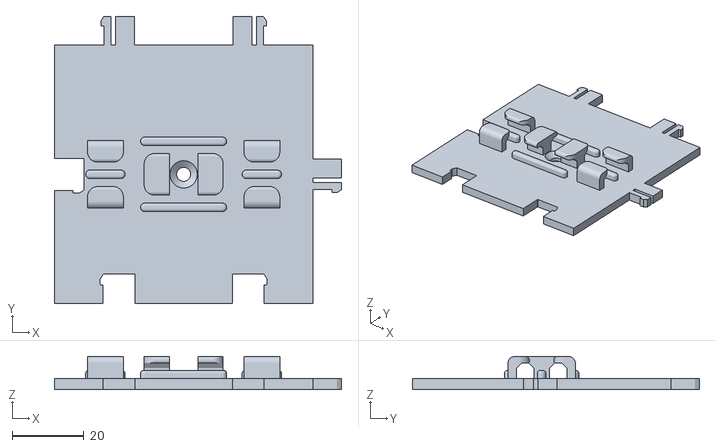
[picture p41: CAD file, 2026-10-27]
druck/v4/01_Kabelkachel_4mm_2spur_print.stl
80.0 x 80.0 x 9.20
