martinkadauke/kabelsalat/bilder/aufbau_oben.png

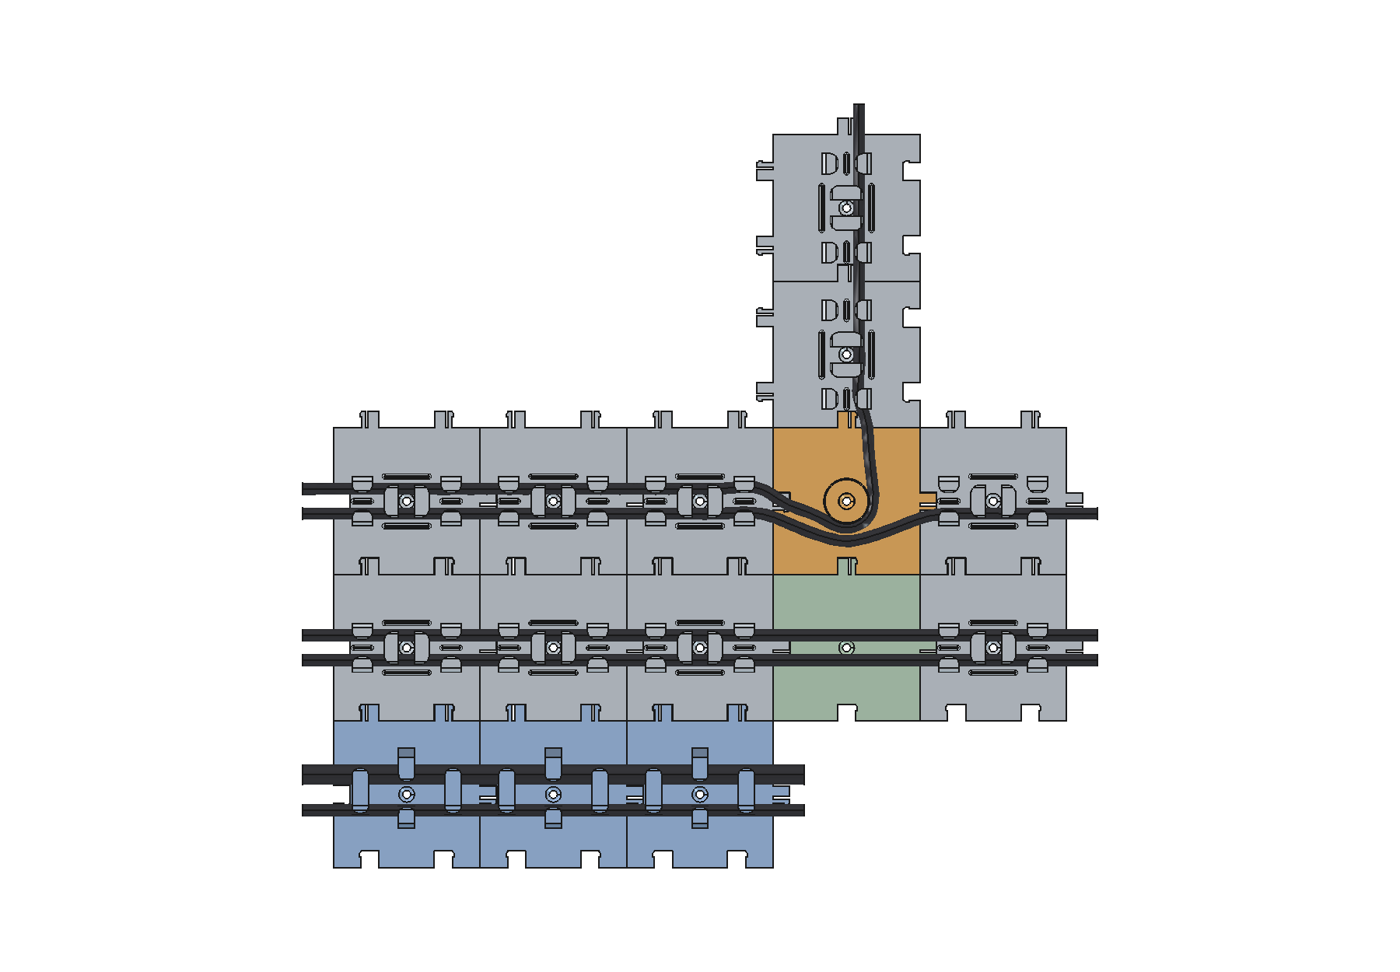
bilder/aufbau_oben.png
