martinkadauke/kabelsalat/bilder/aufbau_ohne_kabel.png

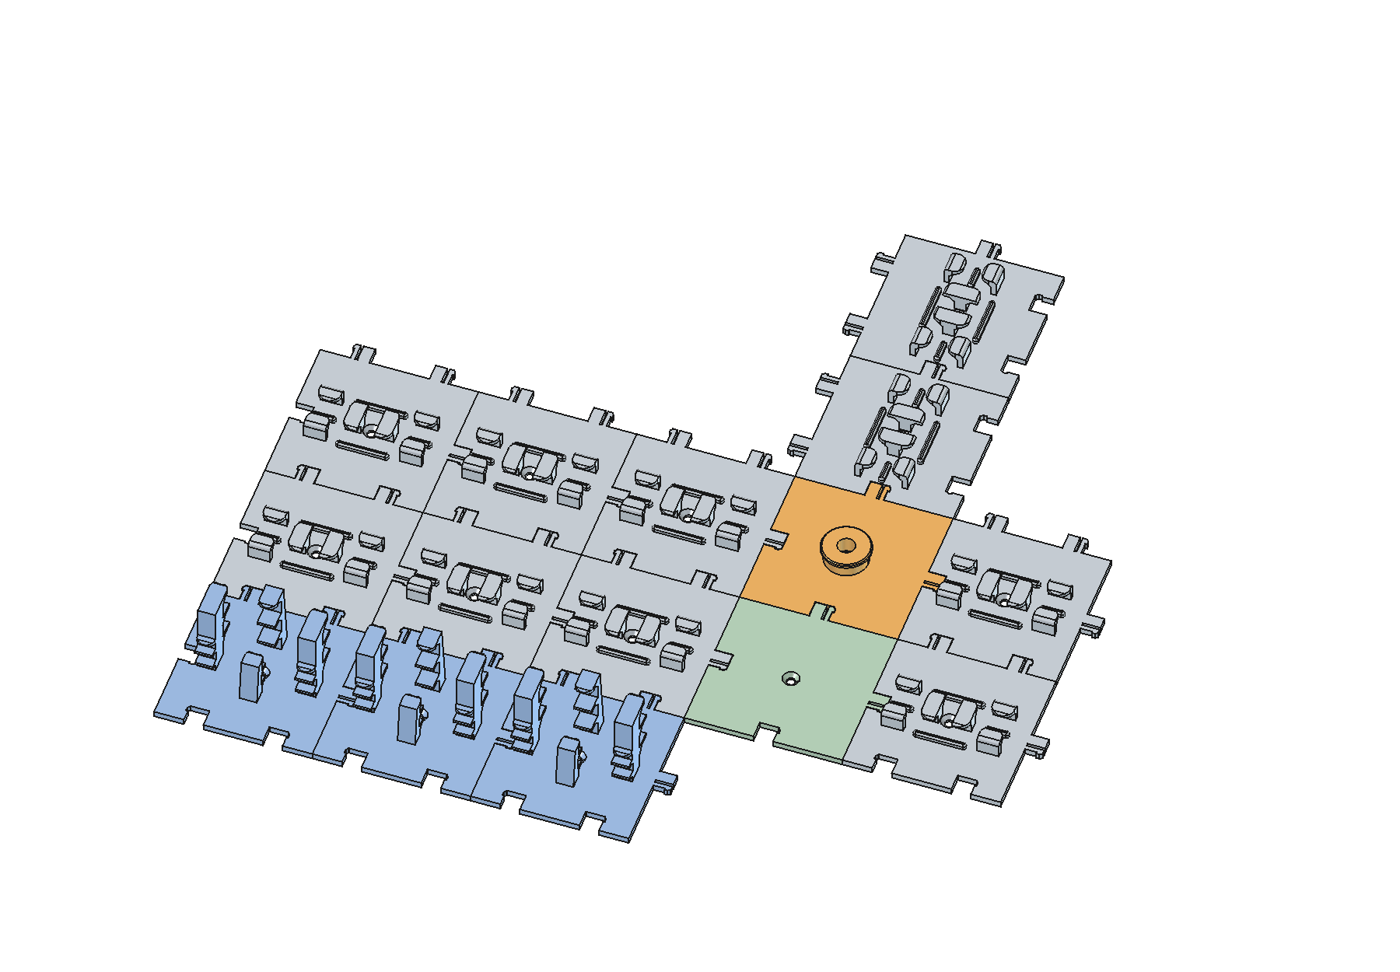
bilder/aufbau_ohne_kabel.png
