martinkadauke/kabelsalat/(commit log)

2026-10-27 Parametric under-desk cable tiles, print set v3 and generator
    FreeCAD model (kabelfuehrung.py) with flat tiles, double and triple decker
    tiles (two trees on a solid keel), roundabout and blank tile. All parts share
    a 72 x 72 mm footprint. Print set for 4/6/8/10 mm cables, a generator window
    that writes STLs and opens them in Bambu Studio, build checks and screenshots.
    [01_Kabelkachel_4mm_2spur_print.stl, 02_Doppeldecker_4mm_print.stl, 03_Dreidecker_4mm_print.stl, 04_Kabelkachel_6mm_2spur_print.stl, 05_Doppeldecker_6mm_print.stl, 06_Dreidecker_6mm_print.stl, 07_Kabelkachel_8mm_2spur_print.stl, 08_Doppeldecker_8mm_print.stl]
2026-10-27 Decker tiles hold the cable again: alternating hooks (print set v4)
    The v3 decker had every hook of a tree coming from the keel, so each cable
    was open on the outside and held only by a low rail. A test print showed it
    does not grip. In v4 the hooks alternate like on the flat tile: the end hooks
    come from solid keel blocks in the middle, the middle hook from an outer wall.
    The cables of a tree lie straight above each other, the screw sits free in
    the middle gap. Checks now cover that every decker cable is captured on both
    sides and can be laid in. Print set moved to druck/v4.
    [01_Kabelkachel_4mm_2spur_print.stl, 02_Doppeldecker_4mm_print.stl, 03_Dreidecker_4mm_print.stl, 04_Kabelkachel_6mm_2spur_print.stl, 05_Doppeldecker_6mm_print.stl, 06_Dreidecker_6mm_print.stl, 07_Kabelkachel_8mm_2spur_print.stl, 08_Doppeldecker_8mm_print.stl]
